Special-Topic-2565-01/Training_Base/Training_Based_Final.png

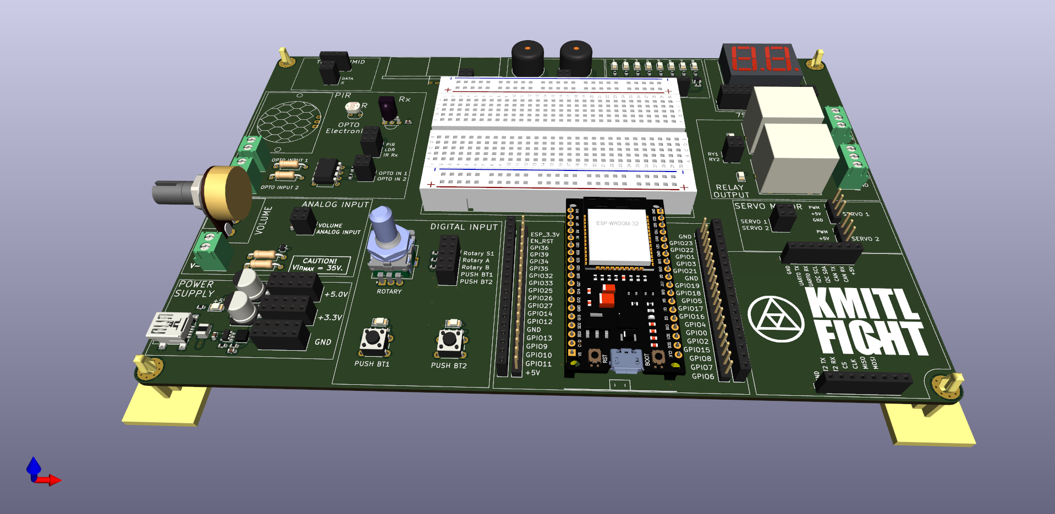
Training_Based_Final.png
