Special-Topic-2565-01/Training_Base/Training_Based.png

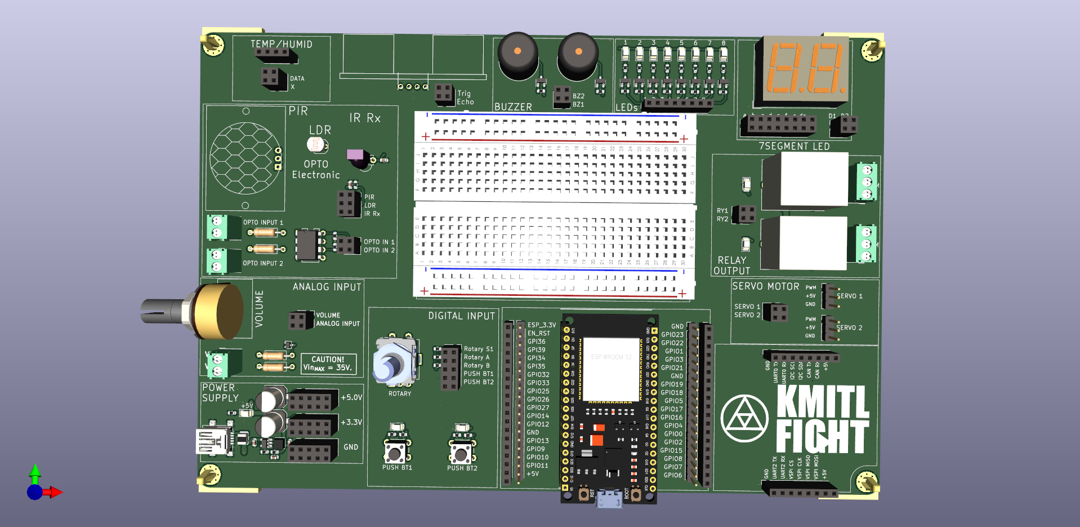
Training_Based.png
