Special-Topic-2565-01/Training_Base/README.md

# Training_Base
Training board base

## Components ##

### Temperature and Humidity sensor ###

## Design tool ##

### Kicad ### 
ใช้ Kicad รุ่นล่าสุด
ดาวน์โหลดจากที่นี่
https://www.kicad.org/download/
