Special-Topic-2565-01/Training_Base/3D Model/fuse_silicon_0603L.step

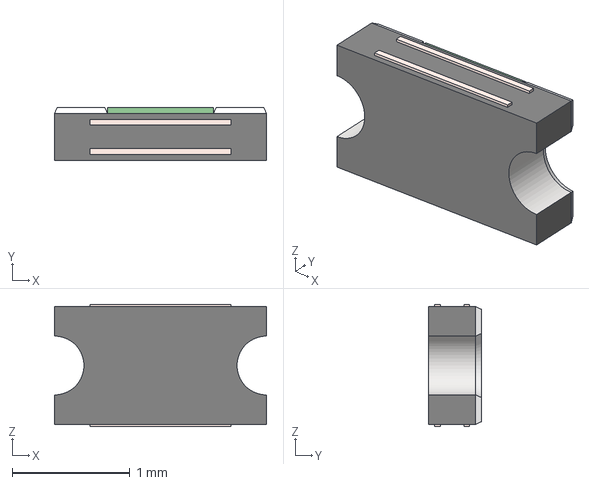
[picture p54: CAD file, 2022-07-24]
3D Model/fuse_silicon_0603L.step
1.80 x 0.45 x 1.04 mm
