Special-Topic-2565-01/Training_Base/3D Model/fuse_silicon_1206L.step

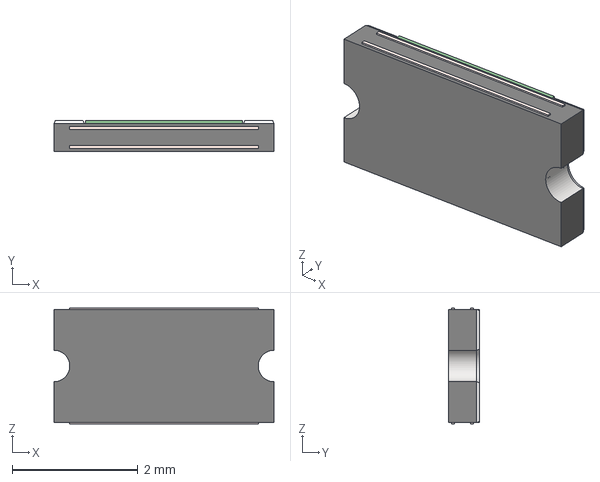
[picture p55: CAD file, 2022-07-24]
3D Model/fuse_silicon_1206L.step
3.50 x 0.5 x 1.84 mm
