Special-Topic-2565-01/Training_Base/3D Model/USB_Mini_B_SMD_buchse.STEP

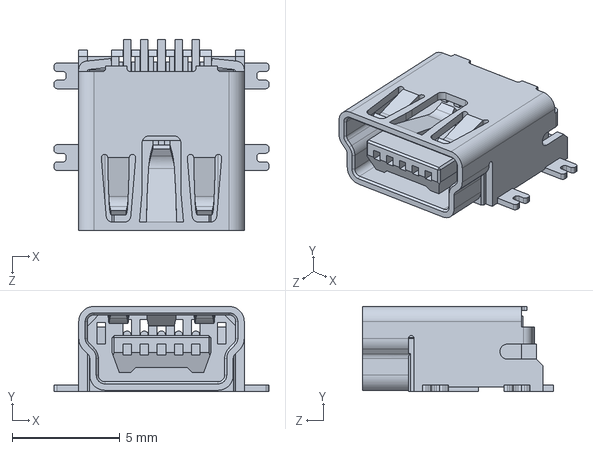
[picture p56: CAD file, 2022-07-24]
3D Model/USB_Mini_B_SMD_buchse.STEP
10.0 x 3.96 x 8.90 mm
