Special-Topic-2565-01/Training_Base/3D Model/fuse_silicon_0805L.step

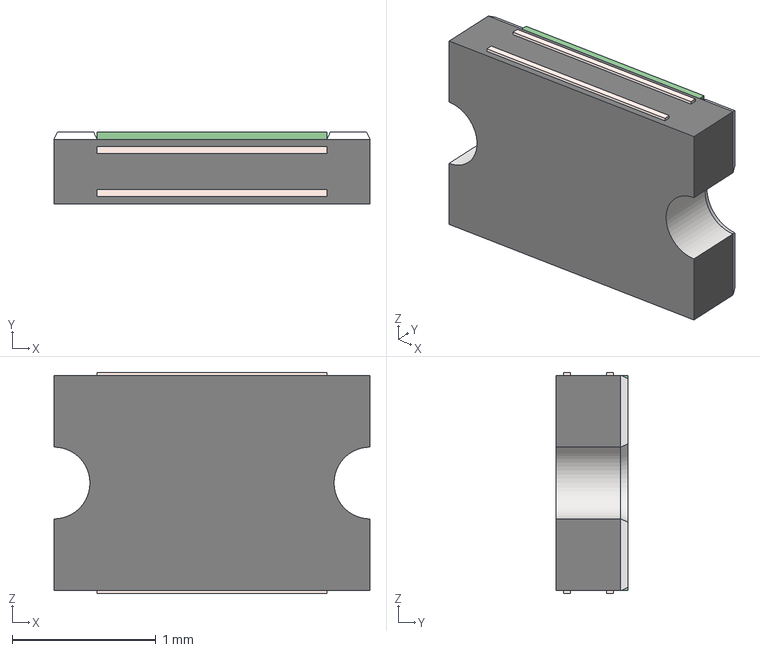
[picture p57: CAD file, 2022-07-24]
3D Model/fuse_silicon_0805L.step
2.20 x 0.5 x 1.54 mm
