Special-Topic-2565-01/Training_Base/3D Model/Potentiometer.step

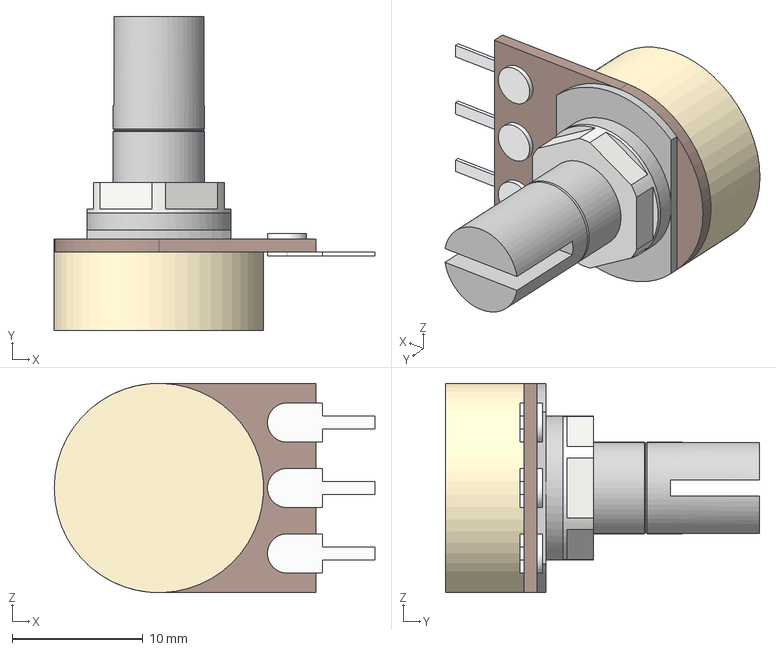
[picture p58: CAD file, 2022-07-24]
3D Model/Potentiometer.step
24.5 x 24.0 x 16.0 mm
Rotary top
Nut and washer
