Special-Topic-2565-01/Training_Base/3D Model/EC11B-SW-Vert-15F-green.step

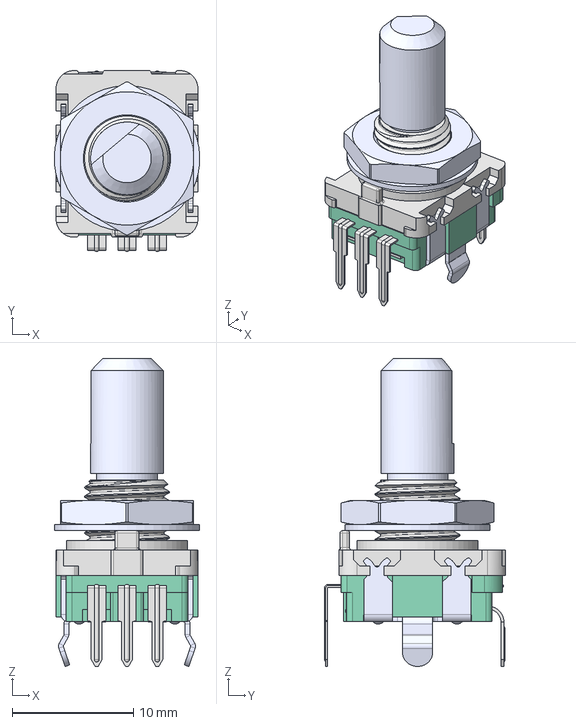
[picture p59: CAD file, 2022-07-24]
3D Model/EC11B-SW-Vert-15F-green.step
12.0 x 14.9 x 25.4 mm
