Special-Topic-2565-01/Training_Base/3D Model/DO-214AC.step

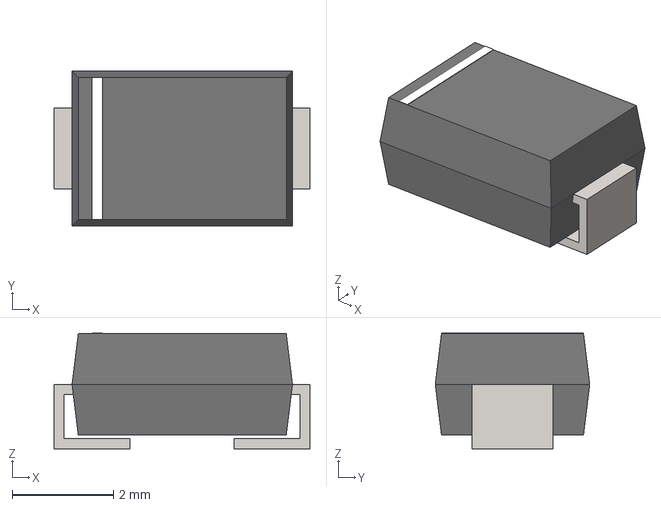
[picture p60: CAD file, 2022-07-23]
3D Model/DO-214AC.step
5.05 x 3.05 x 2.28 mm
