Special-Topic-2565-01/Training_Base/3D Model/DHT11.stp

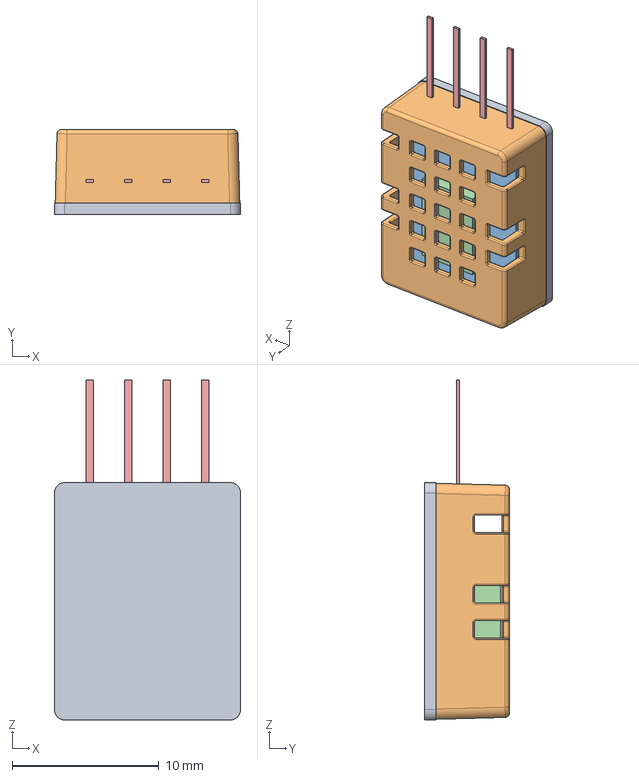
[picture p61: CAD file, 2022-07-23]
3D Model/DHT11.stp
12.7 x 5.80 x 23.2 mm
