Special-Topic-2565-01/Training_Base/3D Model/PIR_sensor board.STEP

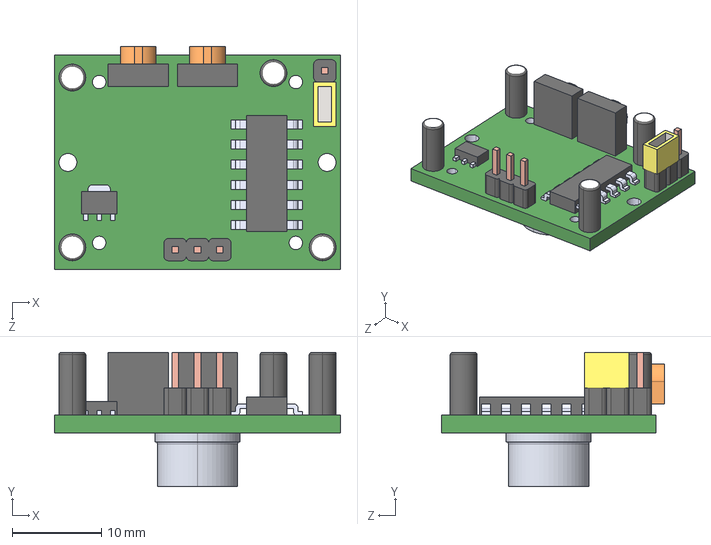
[picture p62: CAD file, 2022-07-22]
3D Model/PIR_sensor board.STEP
32.0 x 15.0 x 25.0 mm
