Special-Topic-2565-01/Training_Base/3D Model/PIR_lens.STEP

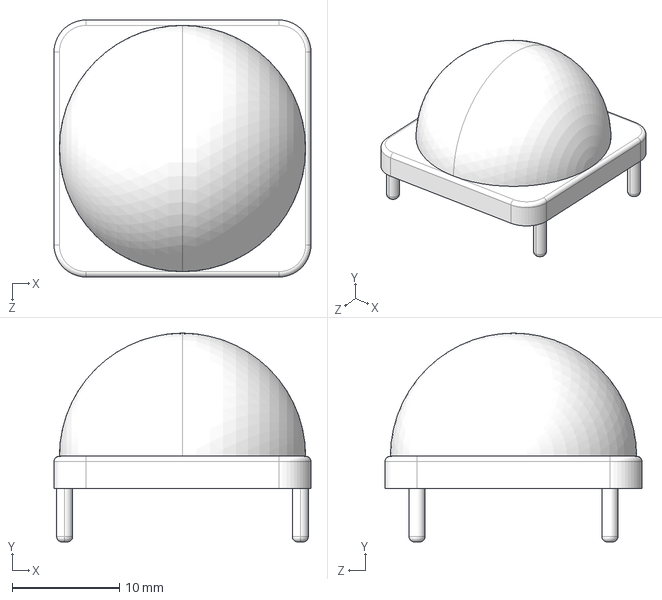
[picture p63: CAD file, 2022-07-22]
3D Model/PIR_lens.STEP
24.0 x 19.5 x 24.0 mm
