Special-Topic-2565-01/Training_Base/3D Model/Plastic Stick Fixed Clip On PCB.stp

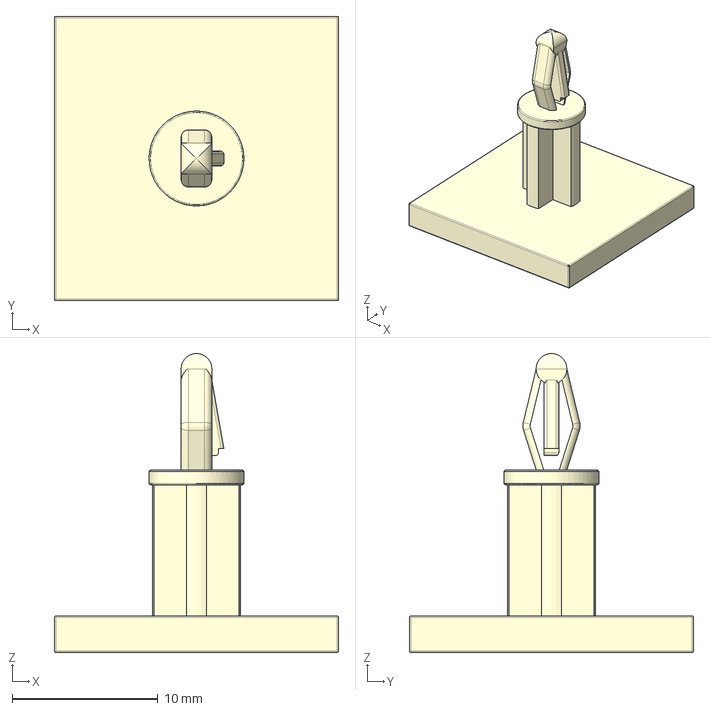
[picture p64: CAD file, 2022-07-21]
3D Model/Plastic Stick Fixed Clip On PCB.stp
19.5 x 19.5 x 20.5 mm
