Special-Topic-2565-01/Training_Base/3D Model/KPM-1205A.STEP

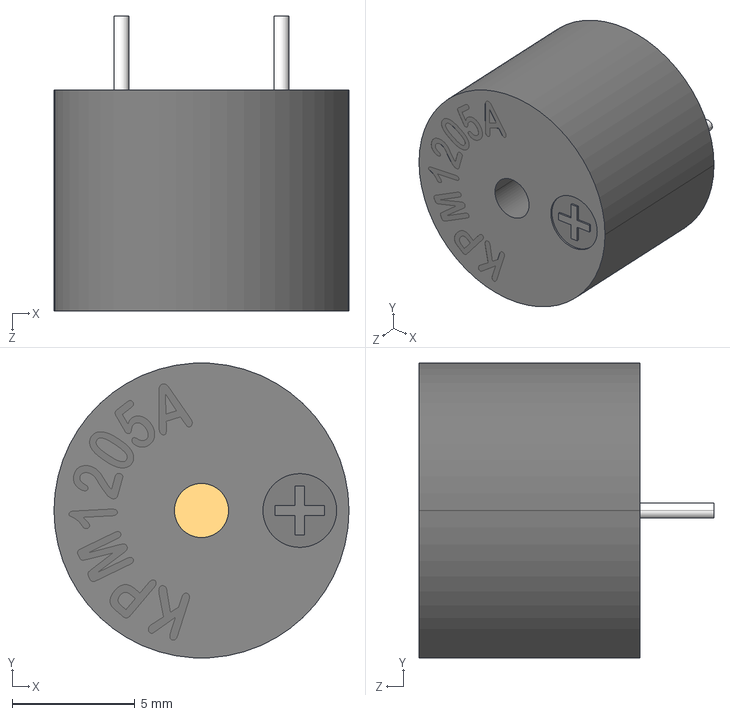
[picture p65: CAD file, 2022-07-21]
3D Model/KPM-1205A.STEP
12.0 x 12.0 x 12.0 mm
