Special-Topic-2565-01/Training_Base/3D Model/Buzzer.step

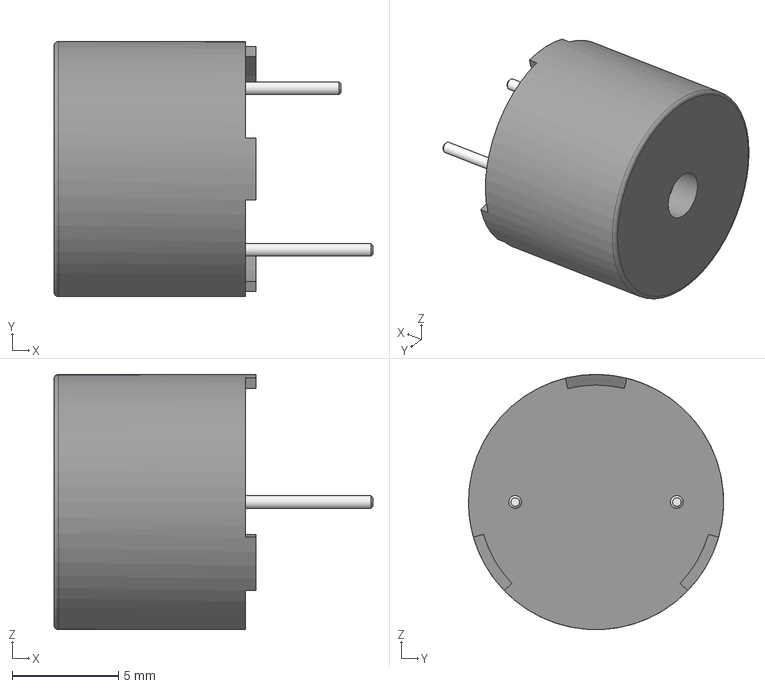
[picture p66: CAD file, 2022-07-21]
3D Model/Buzzer.step
15.0 x 12.0 x 12.0 mm
