Special-Topic-2565-01/Training_Base/3D Model/esp32_devkit_v1_doit.step

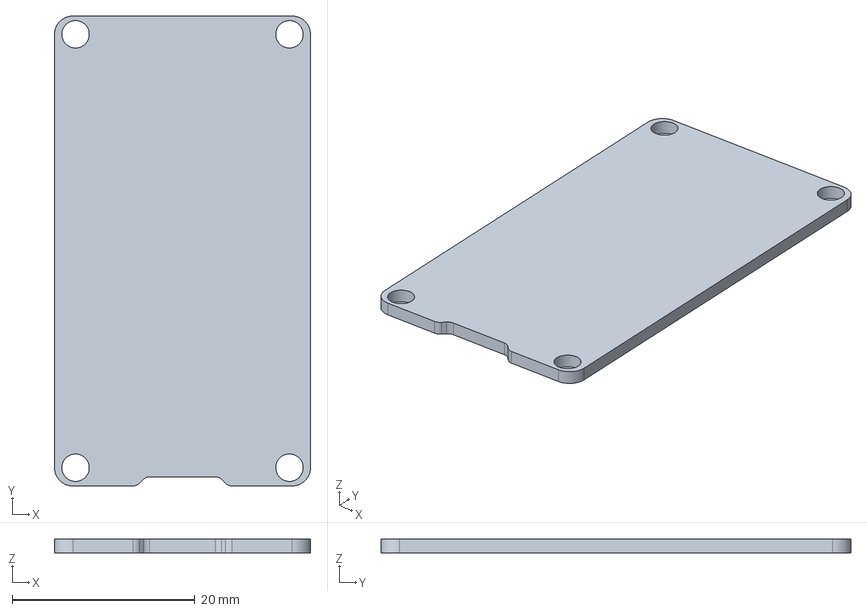
[picture p67: CAD file, 2022-07-21]
3D Model/esp32_devkit_v1_doit.step
28.0 x 51.4 x 1.50 mm
