Special-Topic-2565-01/Training_Base/(list of files, cad)

Other CAD files:
3D Model/PIR_sensor.STEP
