Special-Topic-2565-01/Training_Base/Training_Based.pdf

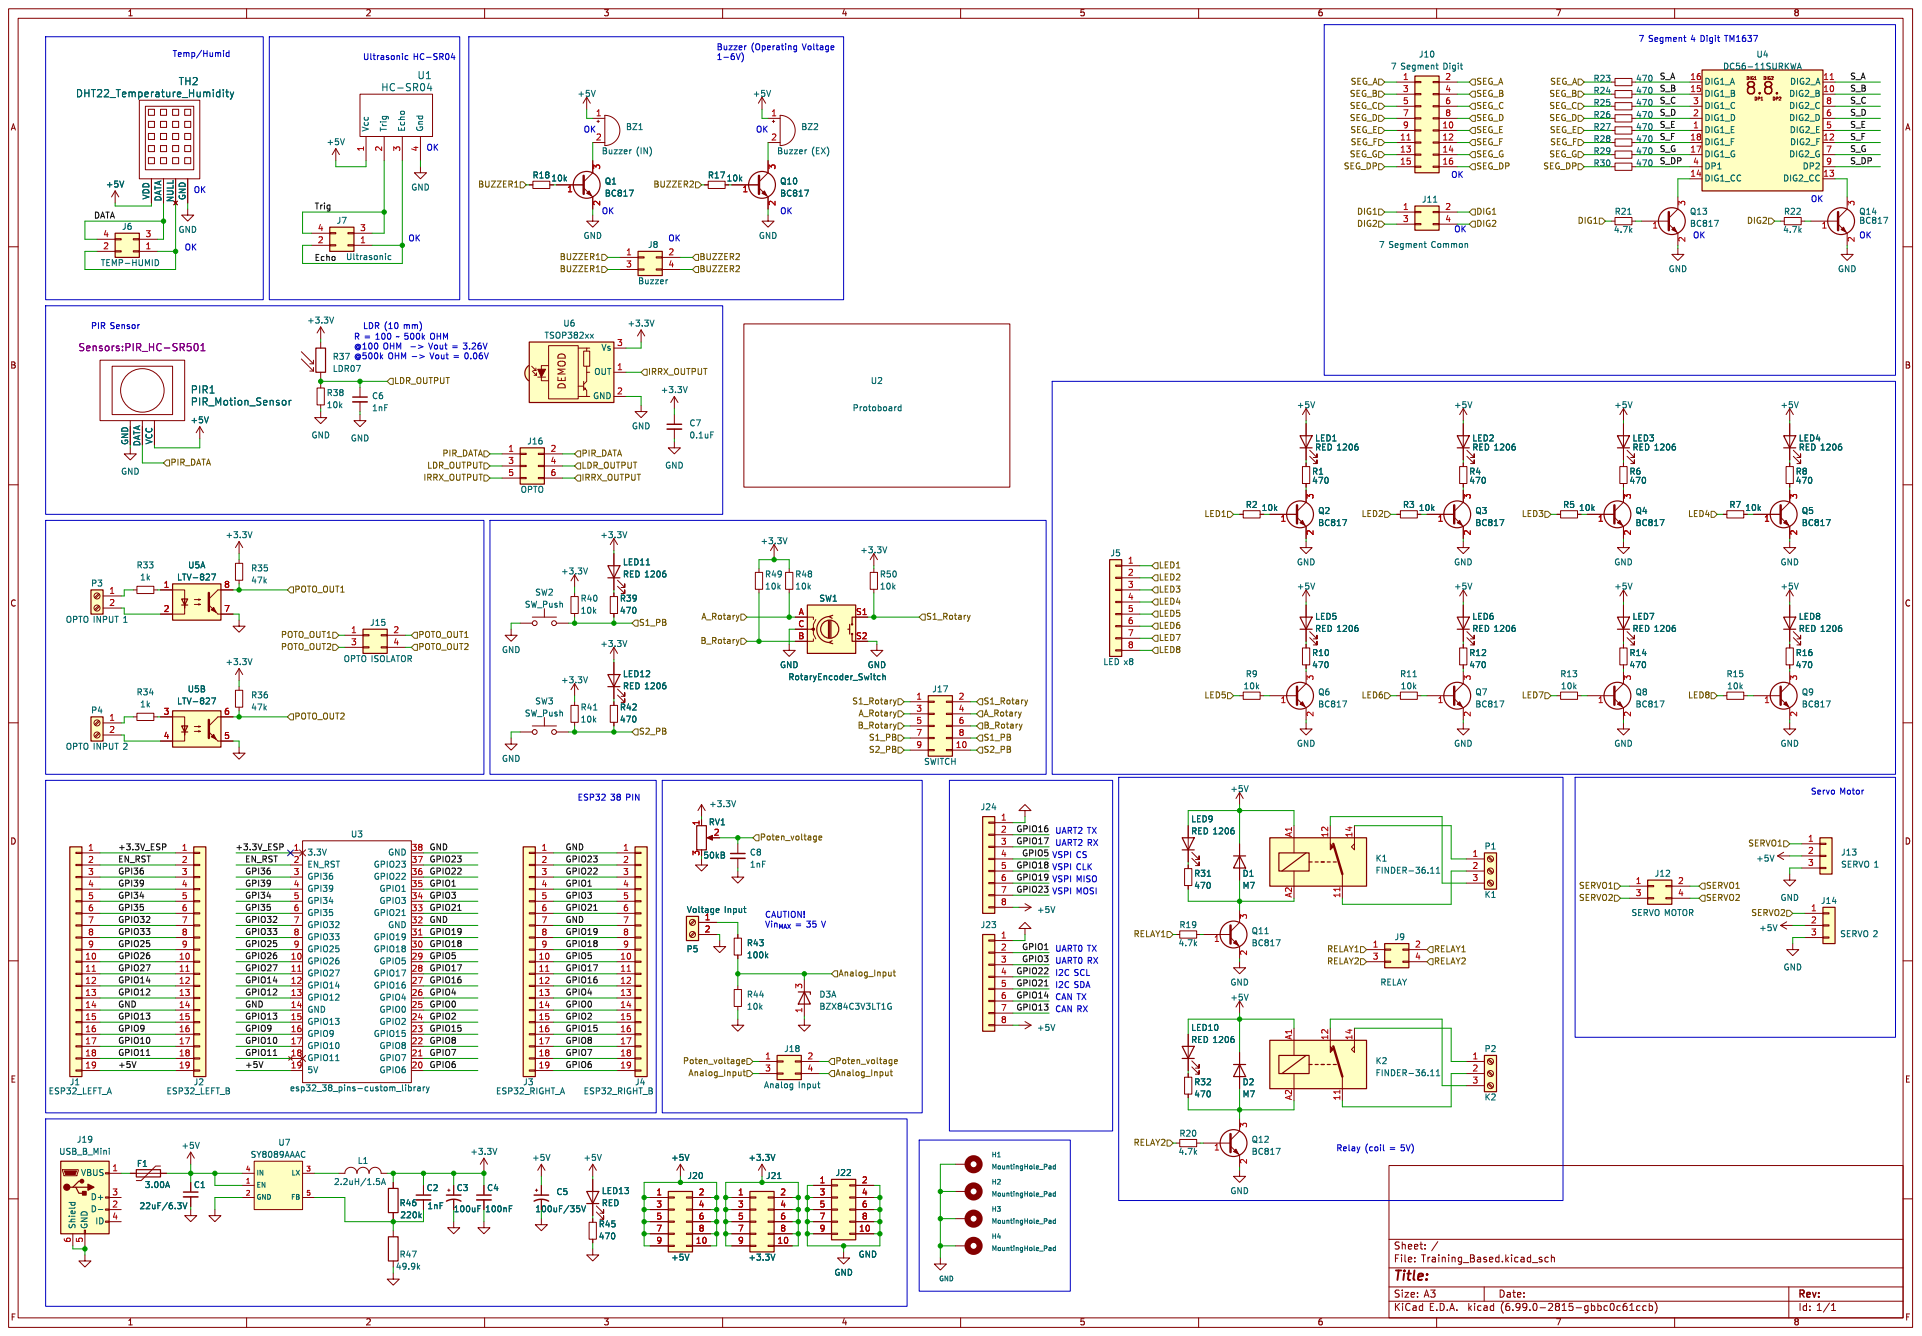
[picture p68: page 1]

LDR (10 mm)
R = 100 ~ 500k OHM @100 OHM -> Vout = 3.26V @500k OHM -> Vout = 0.06V
IRRX_OUTPUTS2_PB

Sensors:PIR_HC-SR501 GND DATA VCC

VSPI CLK CAUTION! Vin_{MAX} = 35 V
