Special-Topic-2565-01/Training_Base/Schematic_650818.pdf

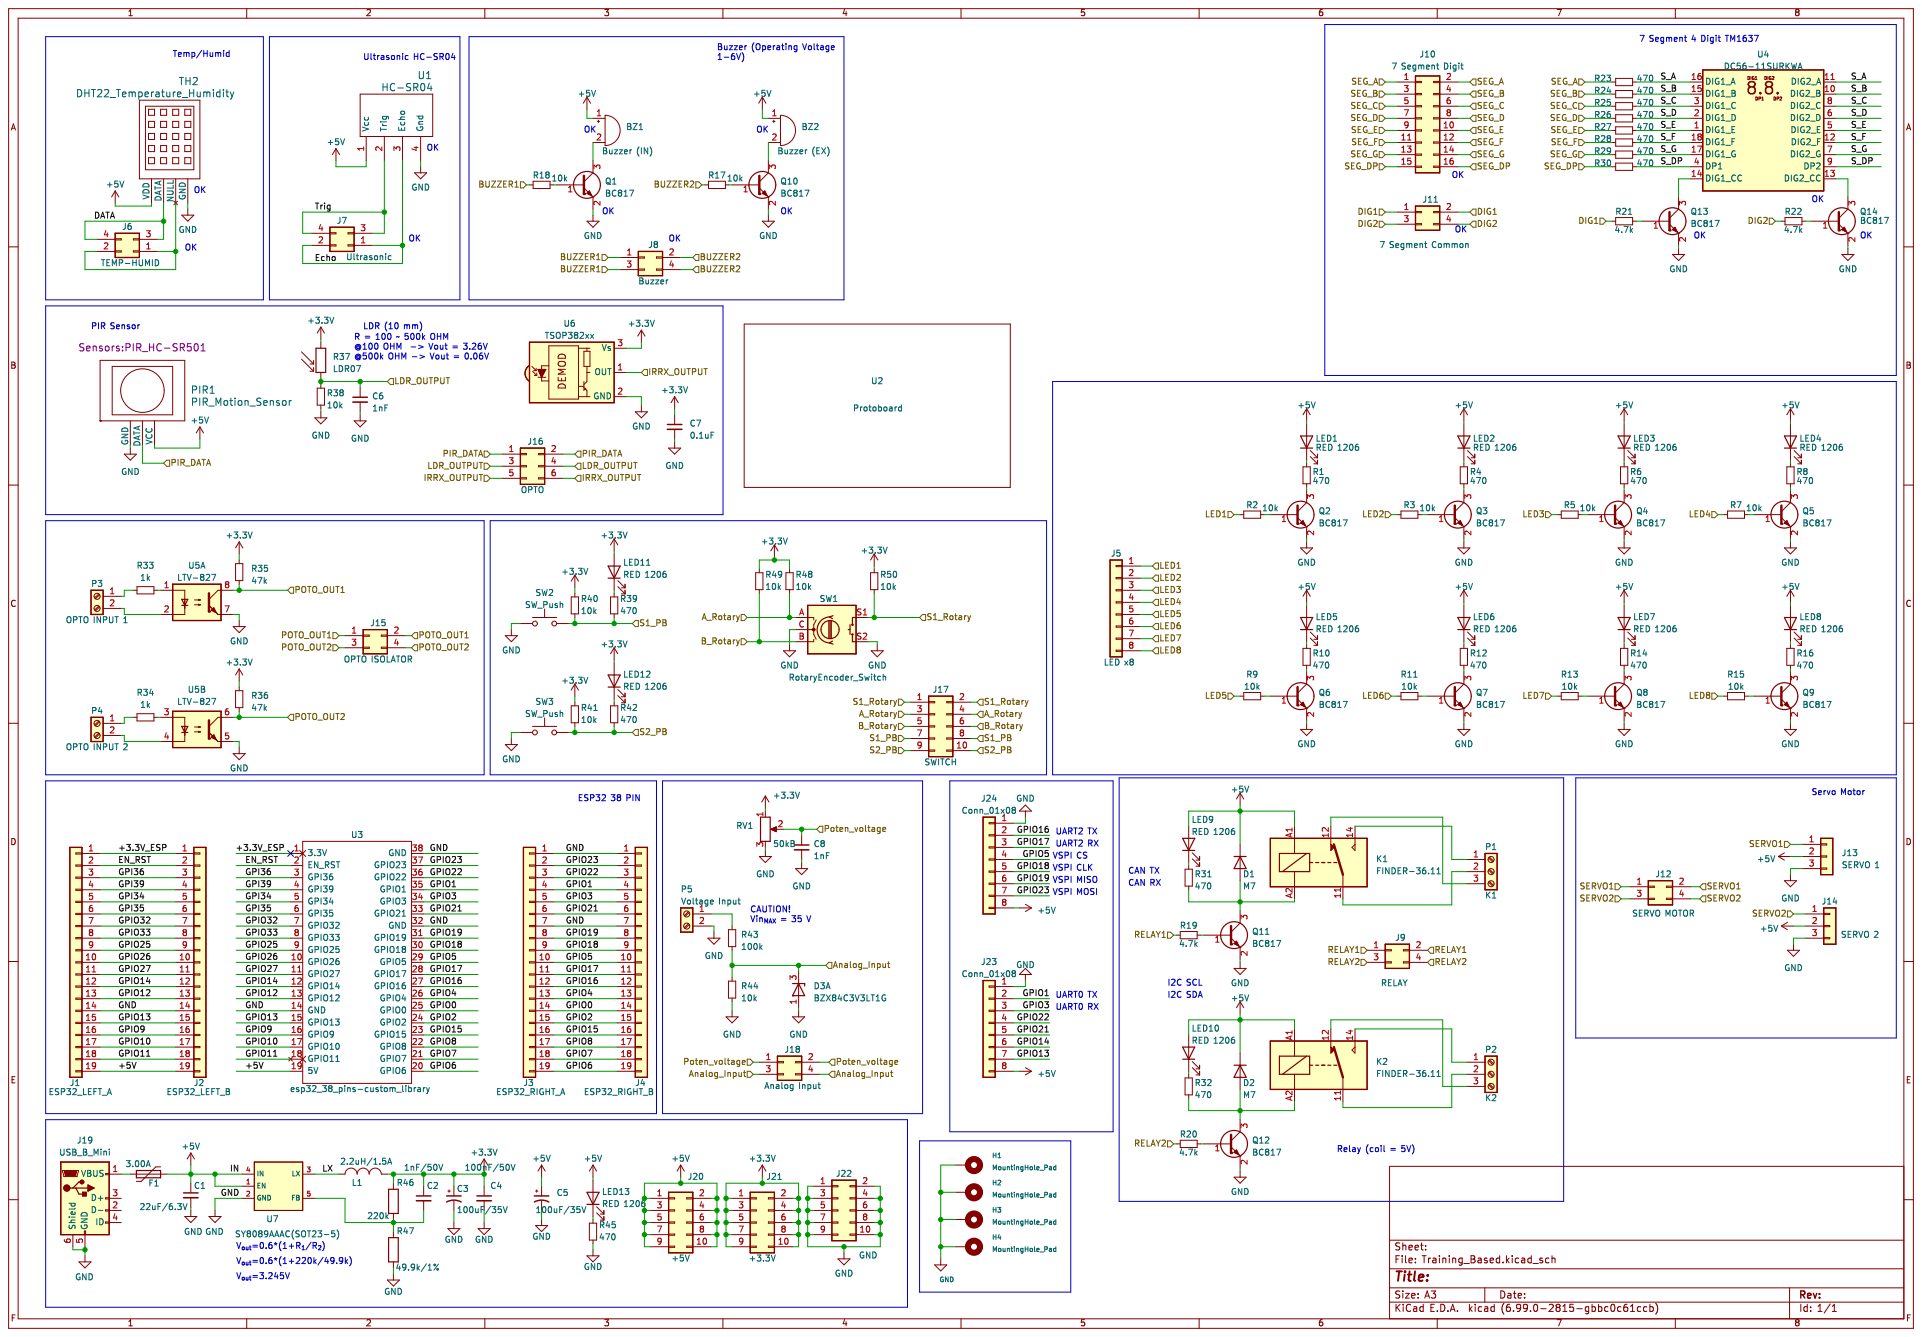
[picture p69: page 1]
