Special-Topic-2565-01/Training_Base/Schematic_650807.pdf

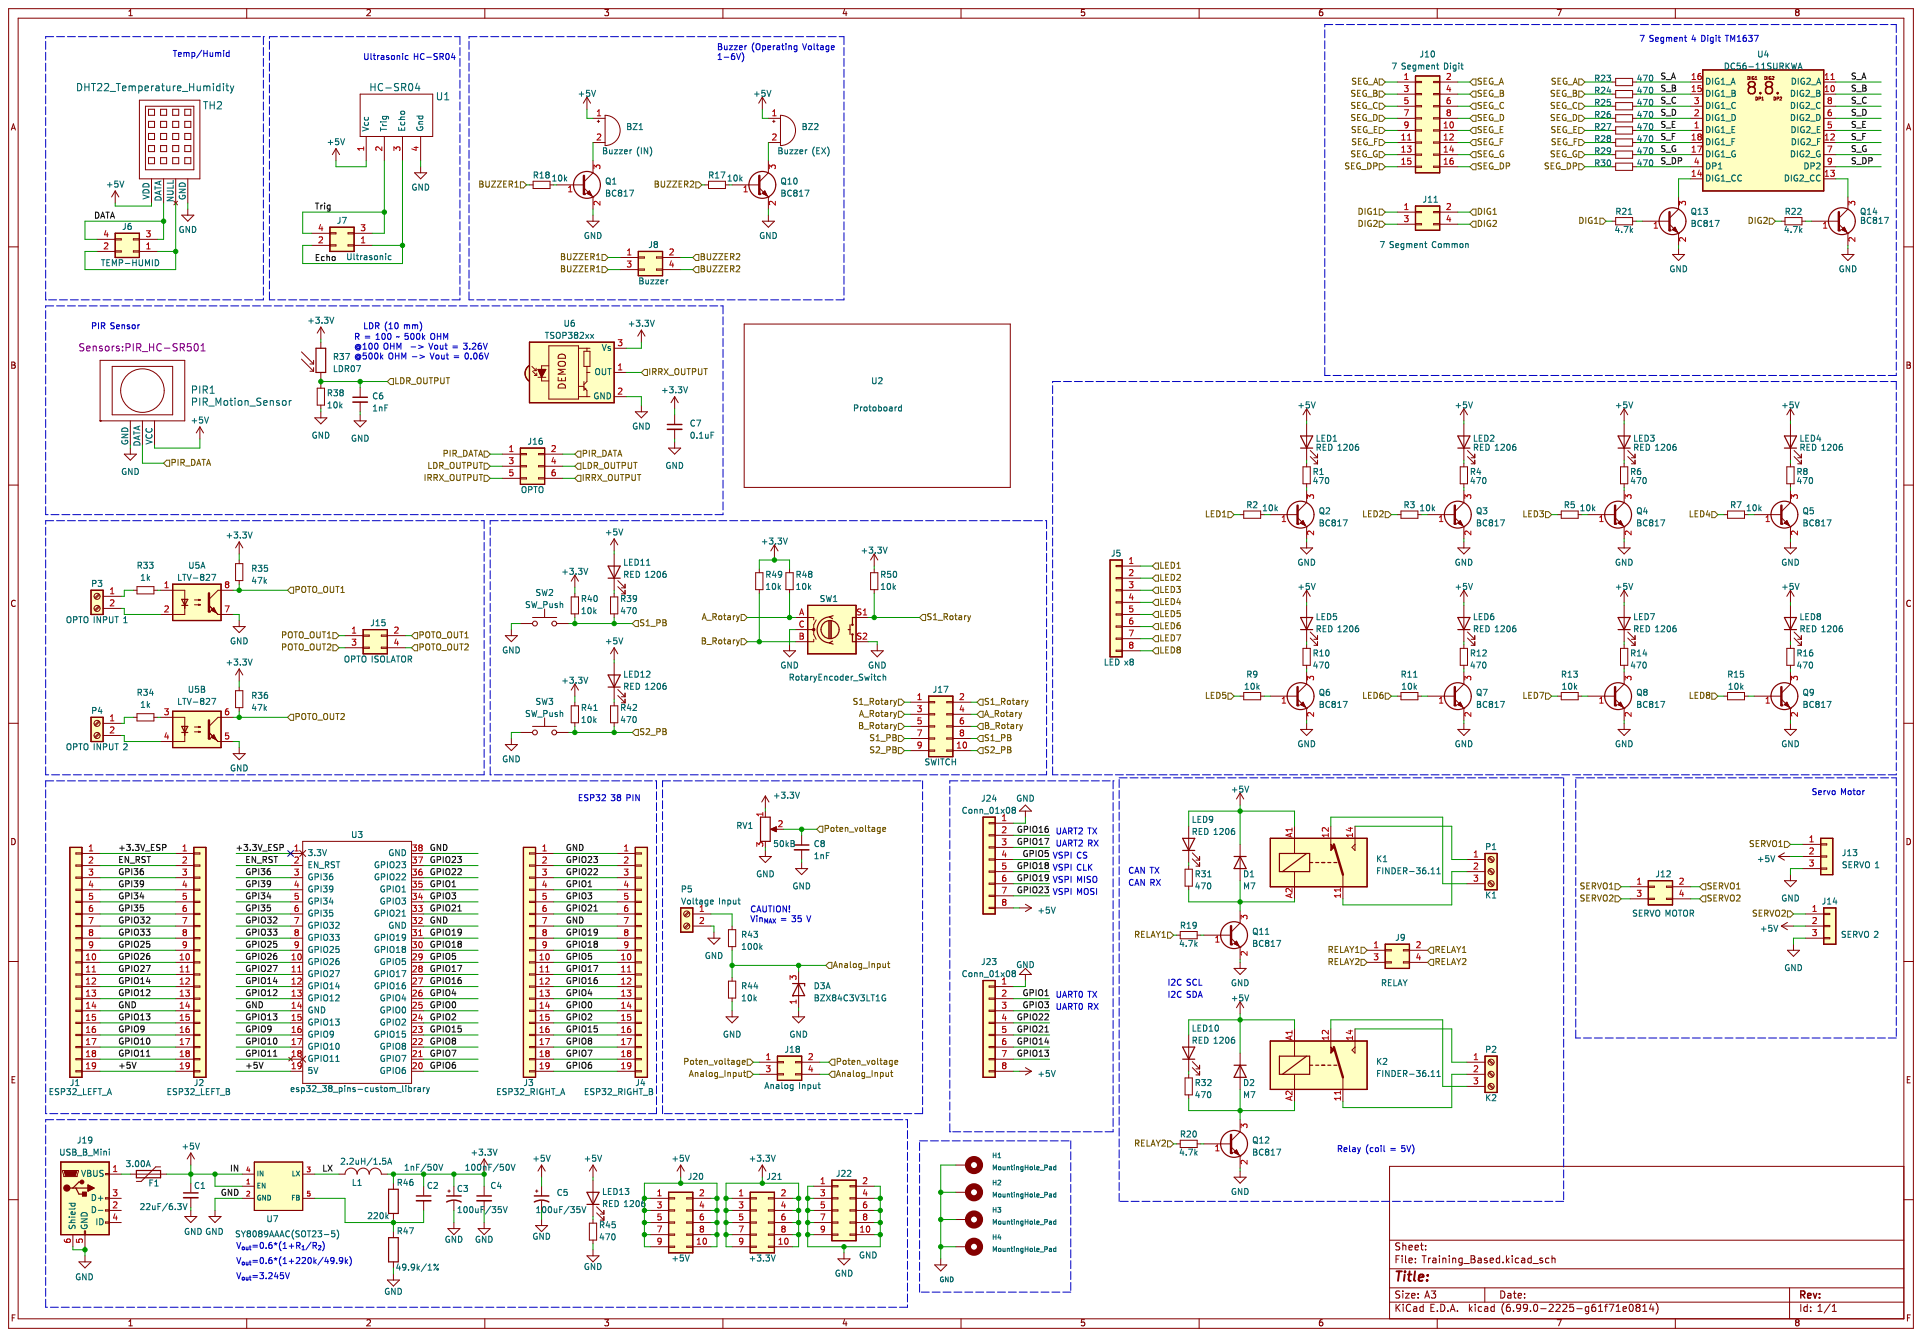
[picture p70: page 1]
