Special-Topic-2565-01/Training_Base/Schematic_650806.pdf

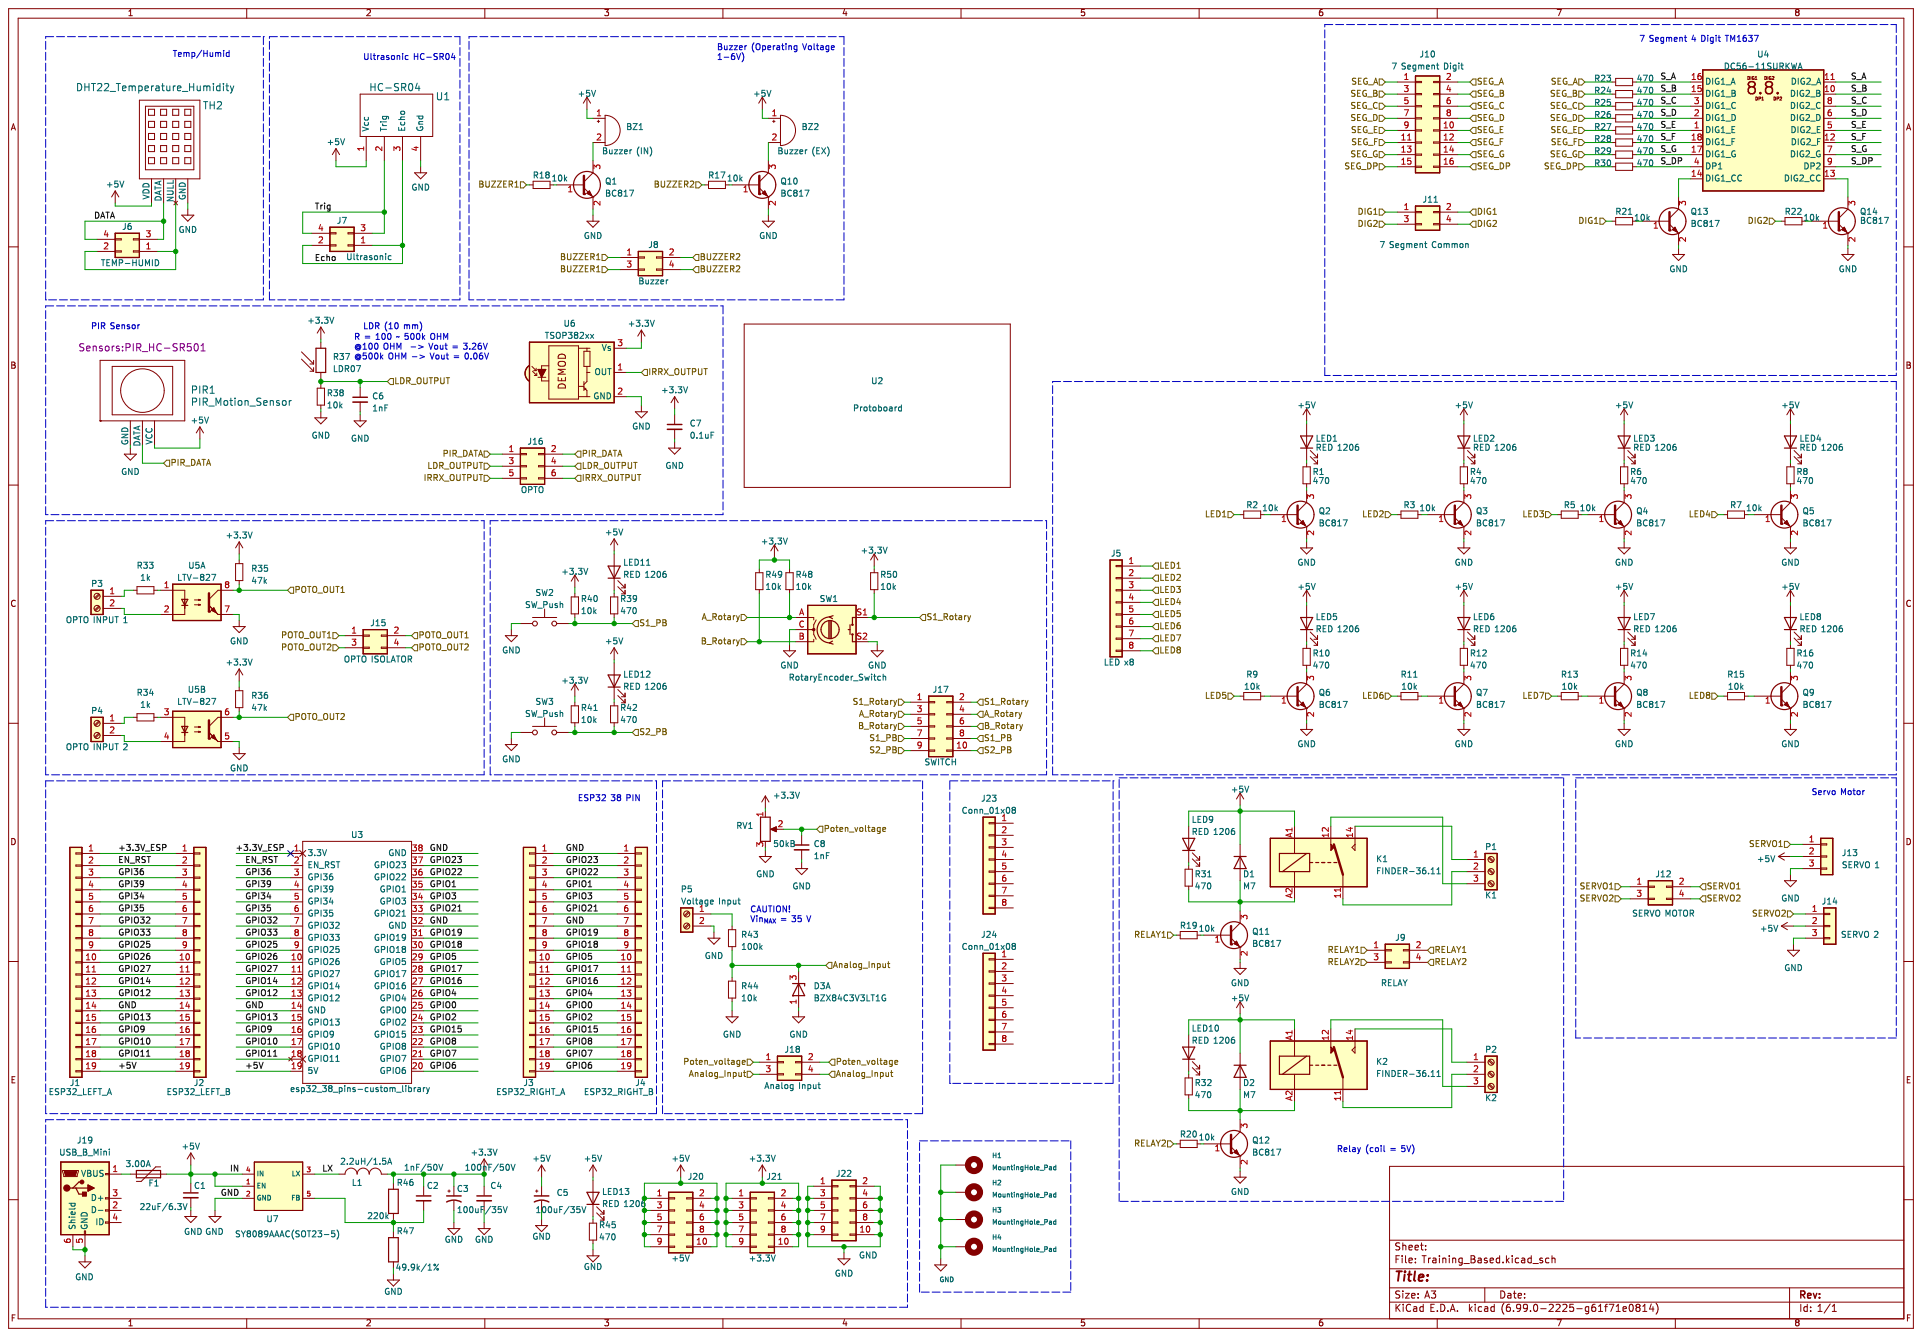
[picture p71: page 1]
