Special-Topic-2565-01/Training_Base/Layout/schematic.pdf

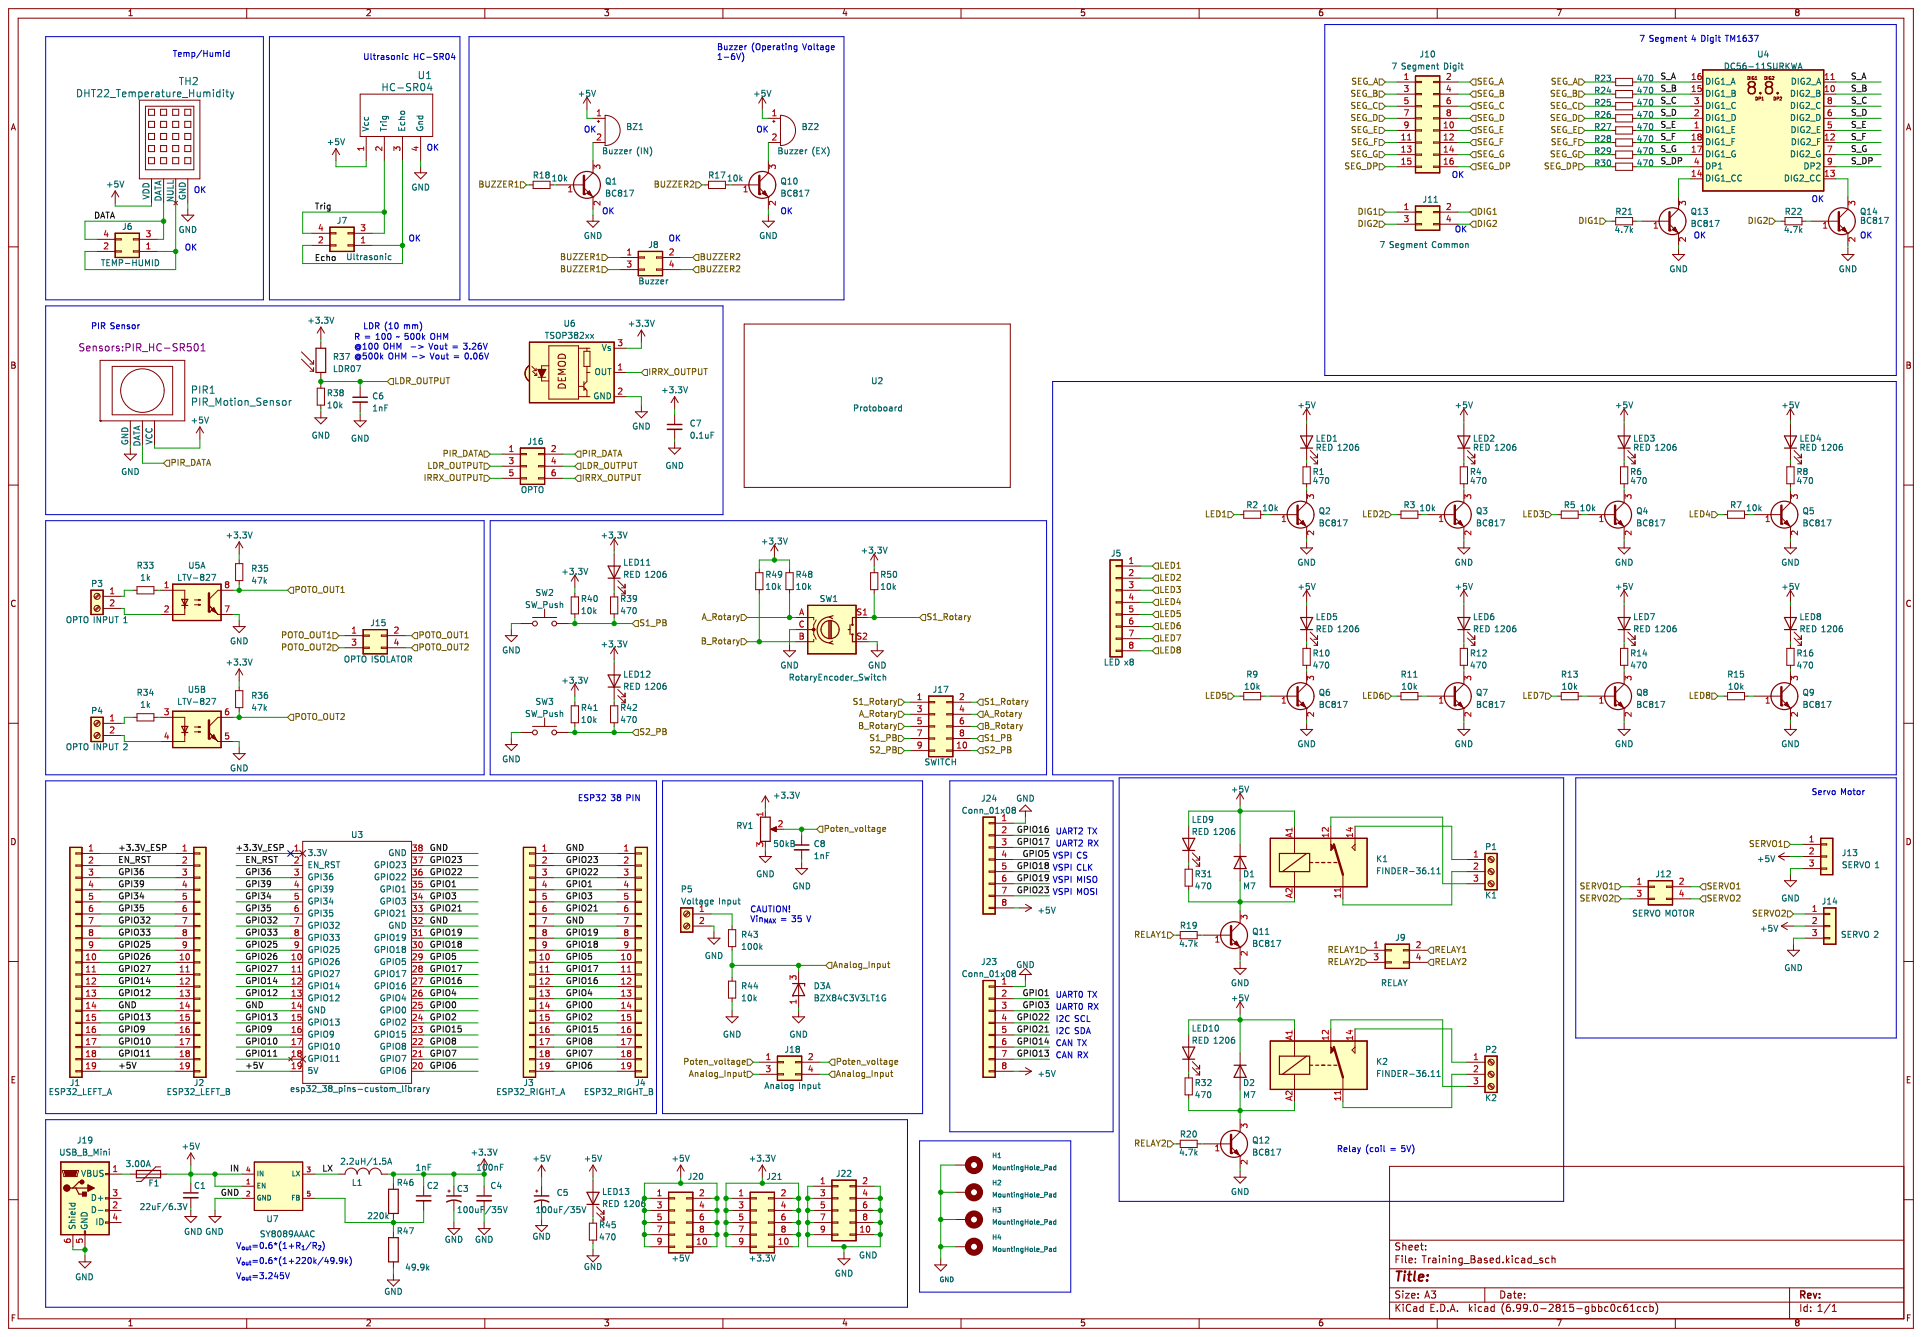
[picture p72: page 1]
