Special-Topic-2565-01/Training_Base/Layout_650807.pdf

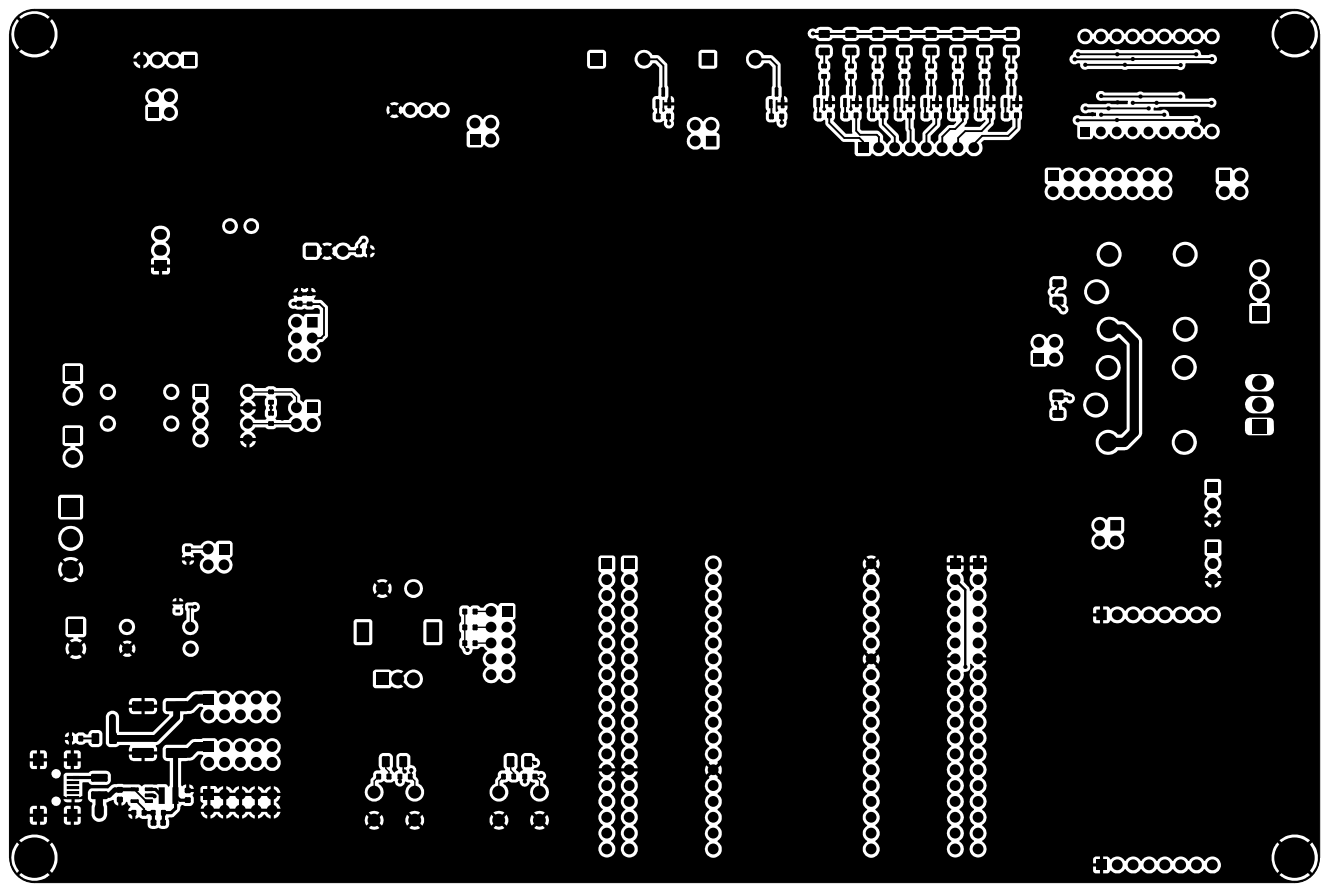
[picture p73: page 1]

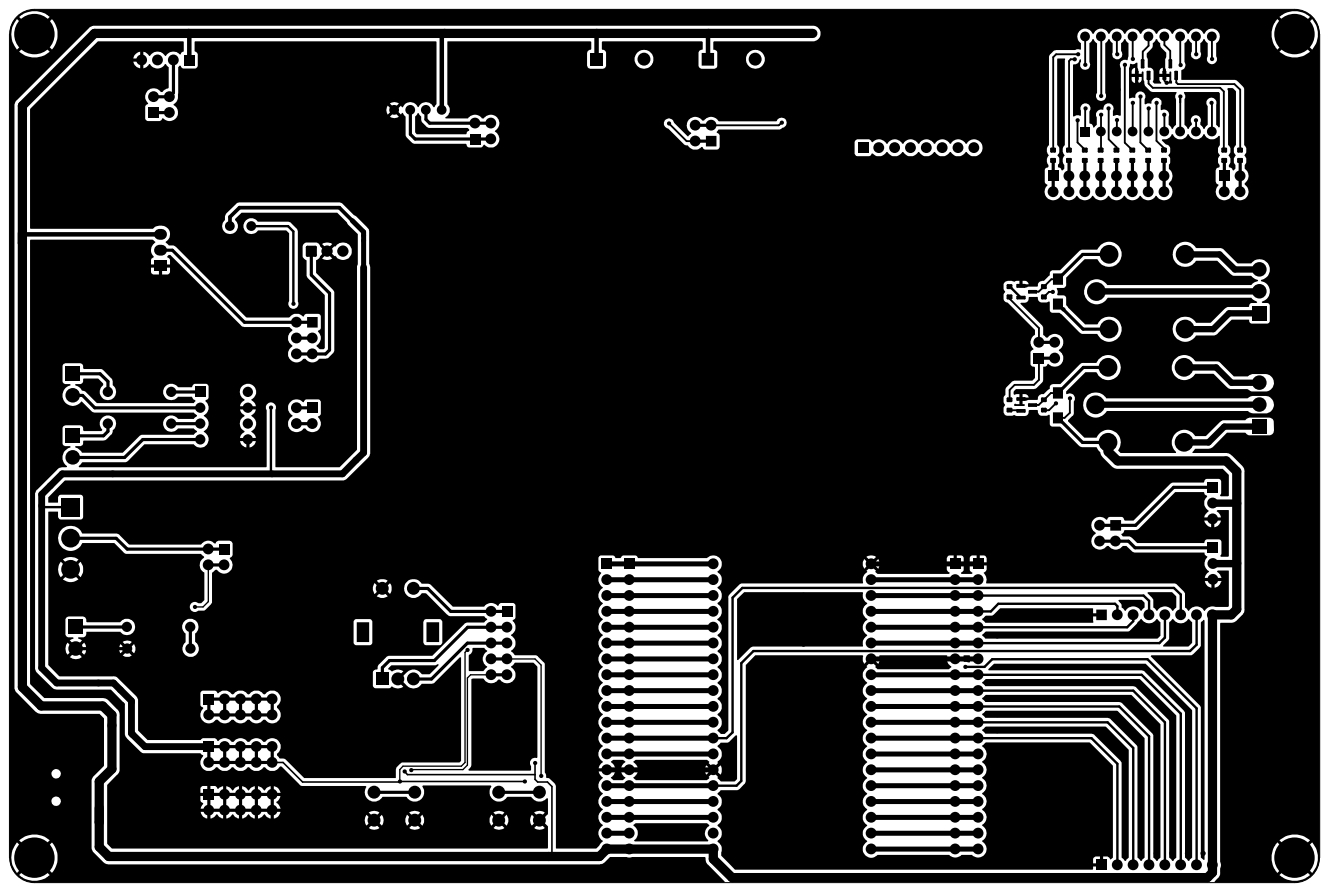
[picture p74: page 2]

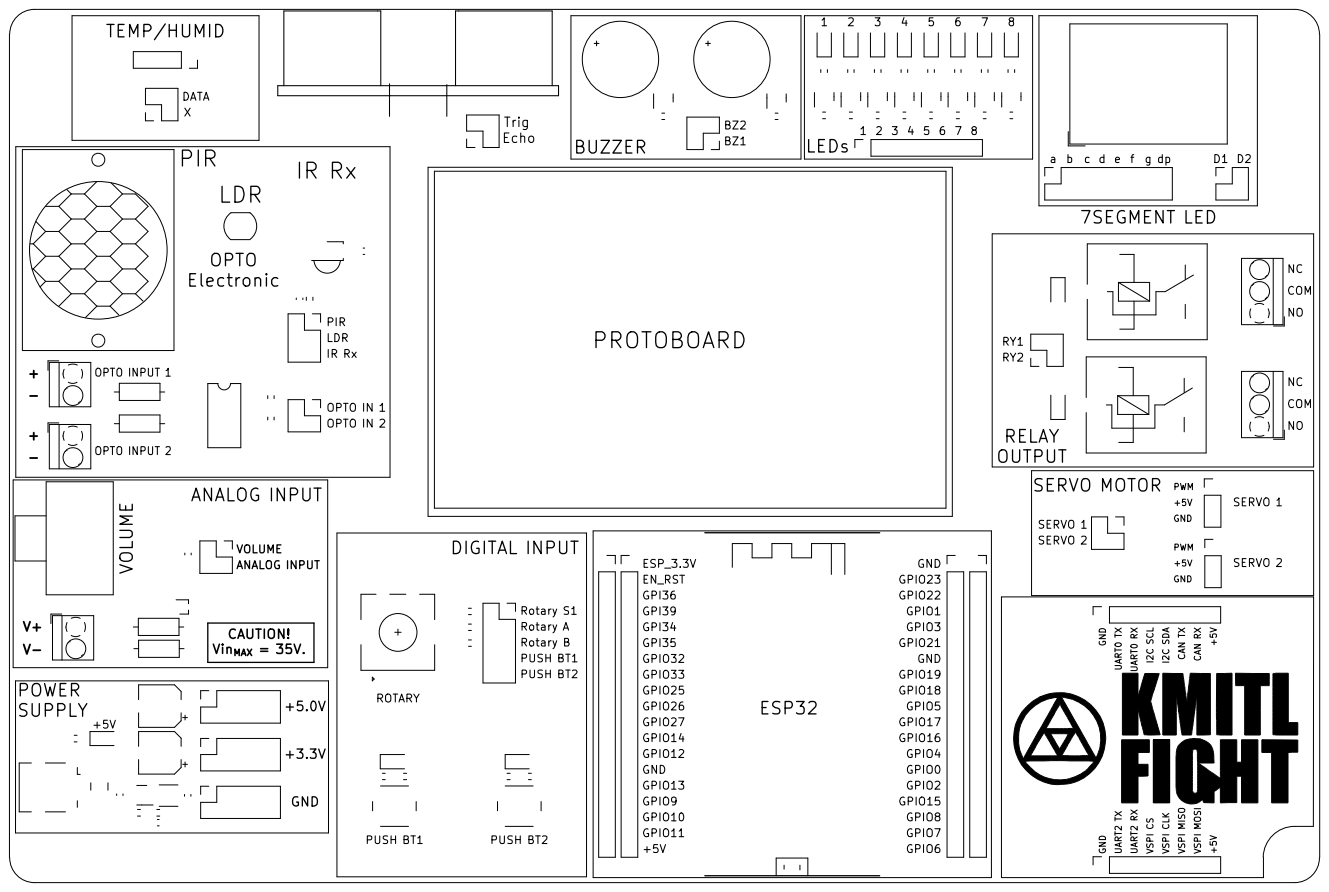
[picture p75: page 3]

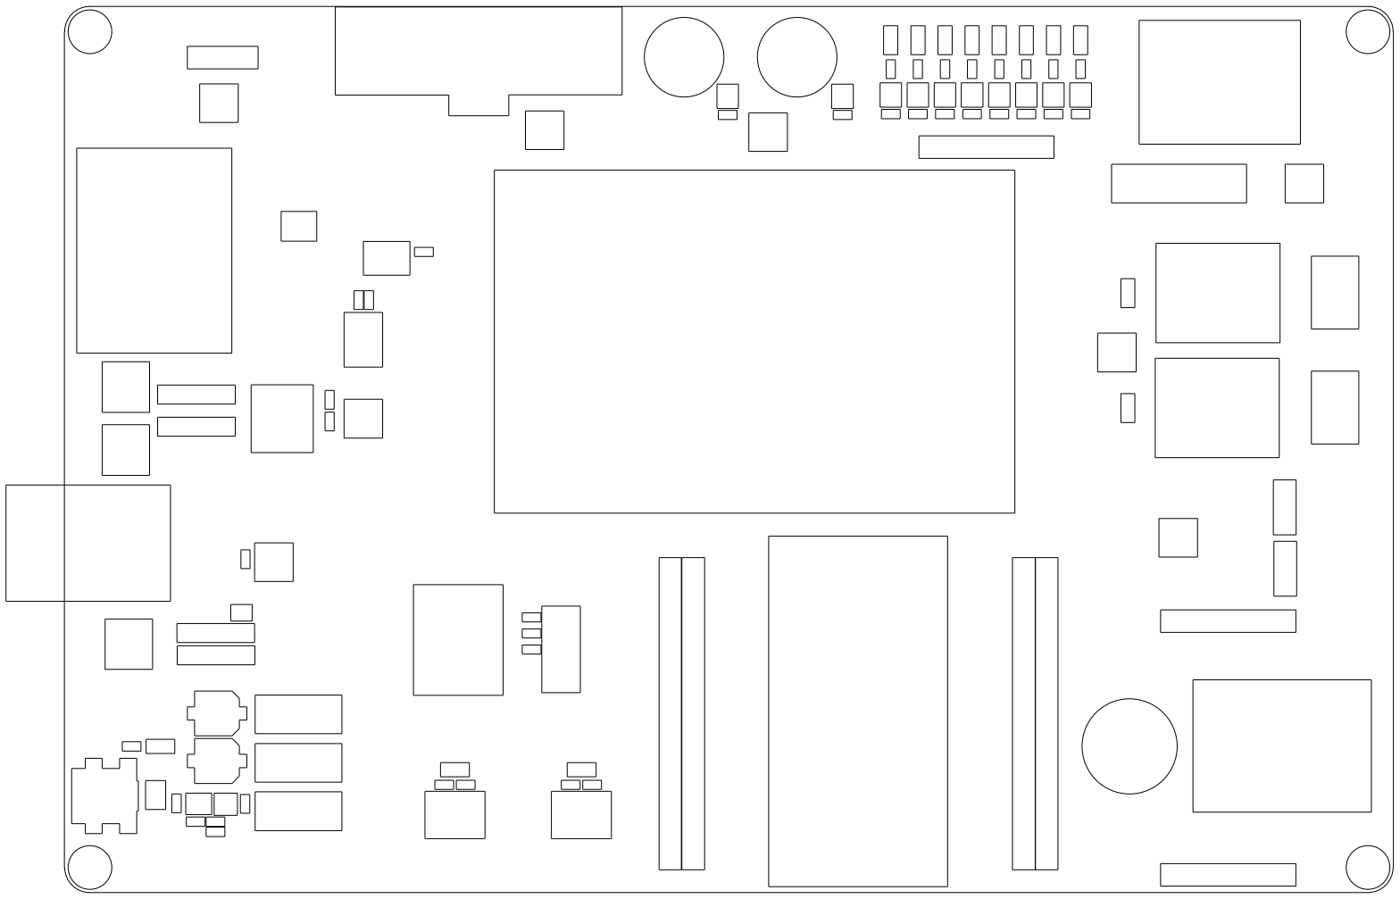
[picture p76: figure]
