Special-Topic-2565-01/Training_Base/layout_rev1.pdf

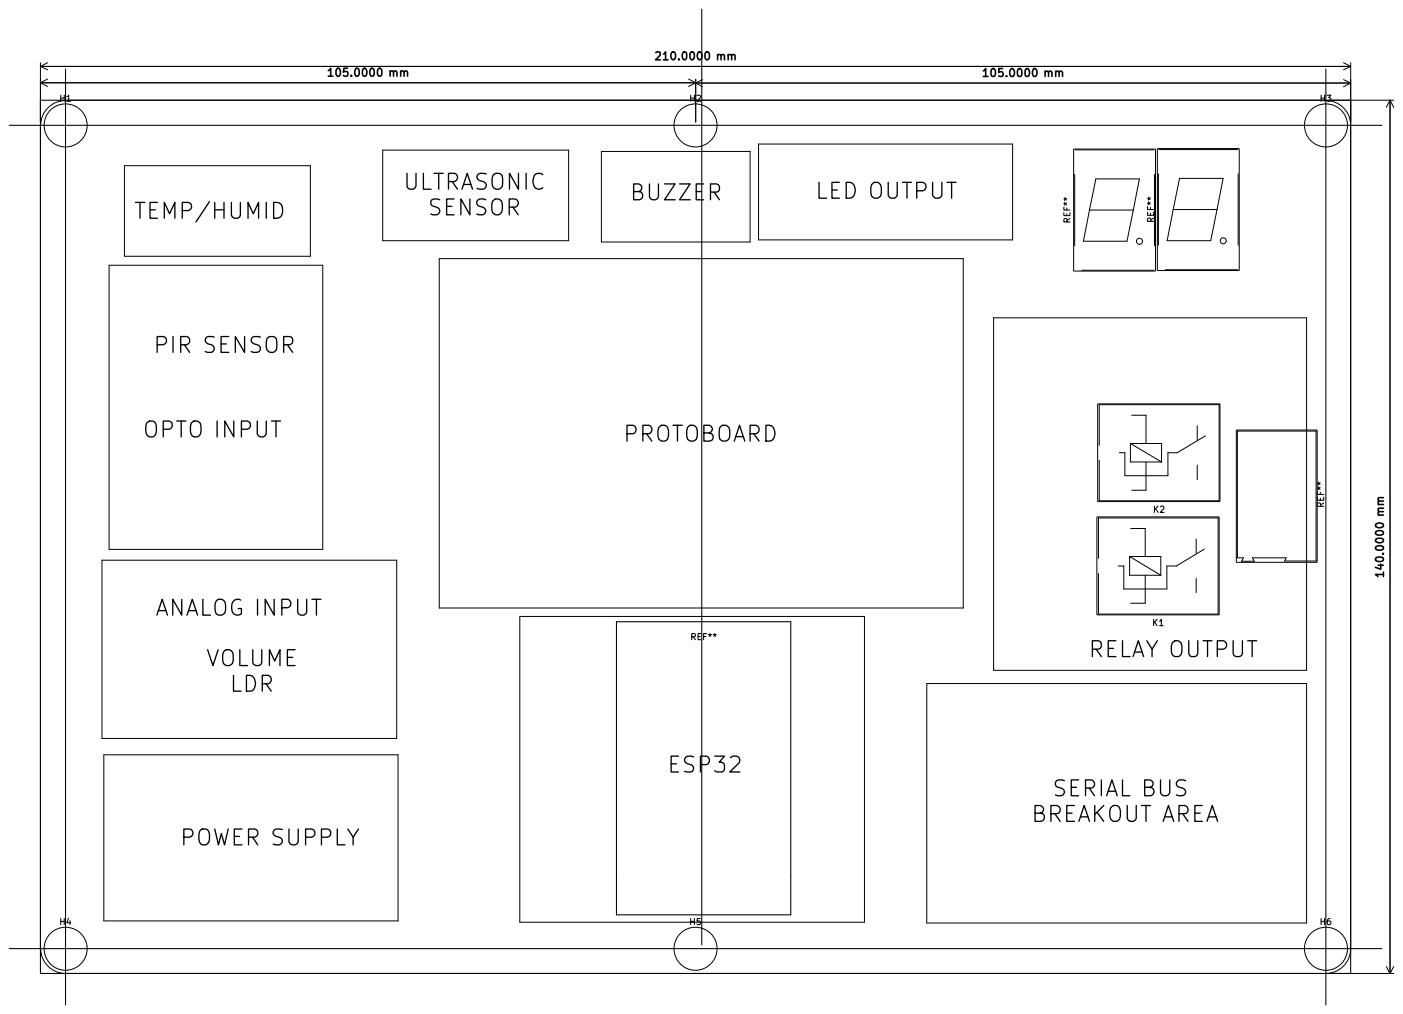
[picture p77: page 1]
