Special-Topic-2565-01/Training_Base/Gerber/Training_Based-B_Cu.pdf

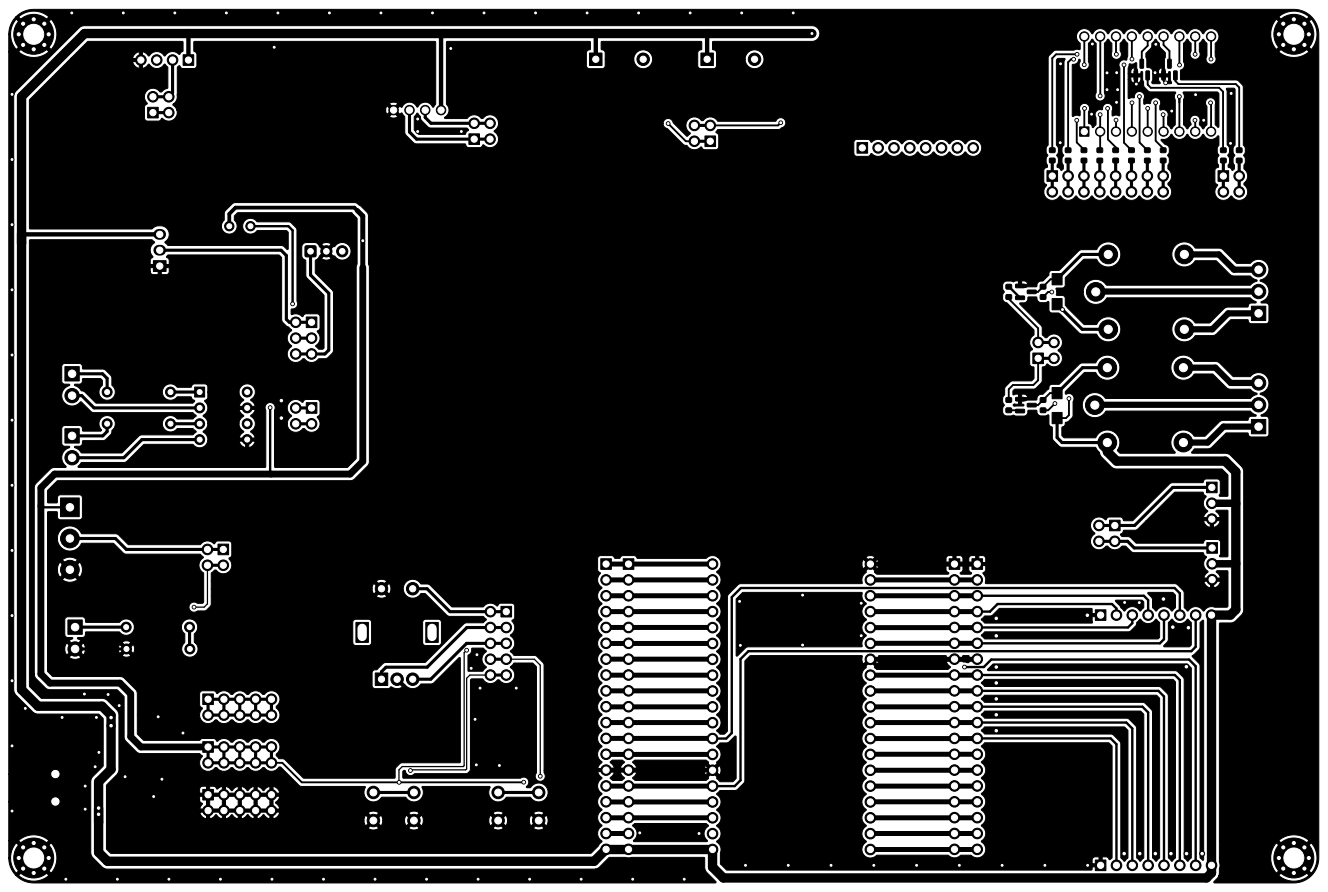
[picture p78: page 1]
