Special-Topic-2565-01/Training_Base/Gerber/Training_Based-F_Cu.pdf

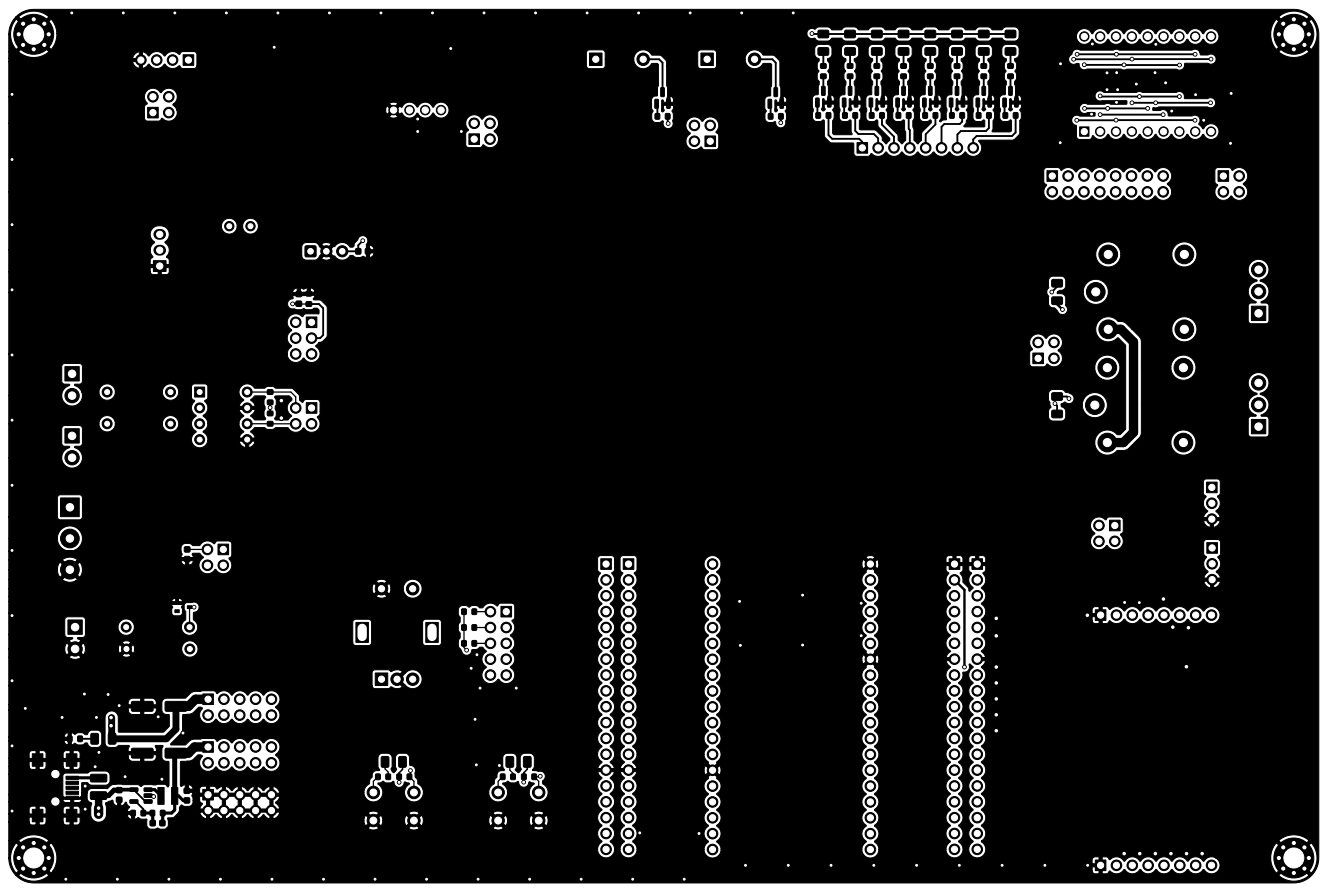
[picture p79: page 1]
