Special-Topic-2565-01/Training_Base/Gerber/Training_Based-F_Silkscreen.pdf

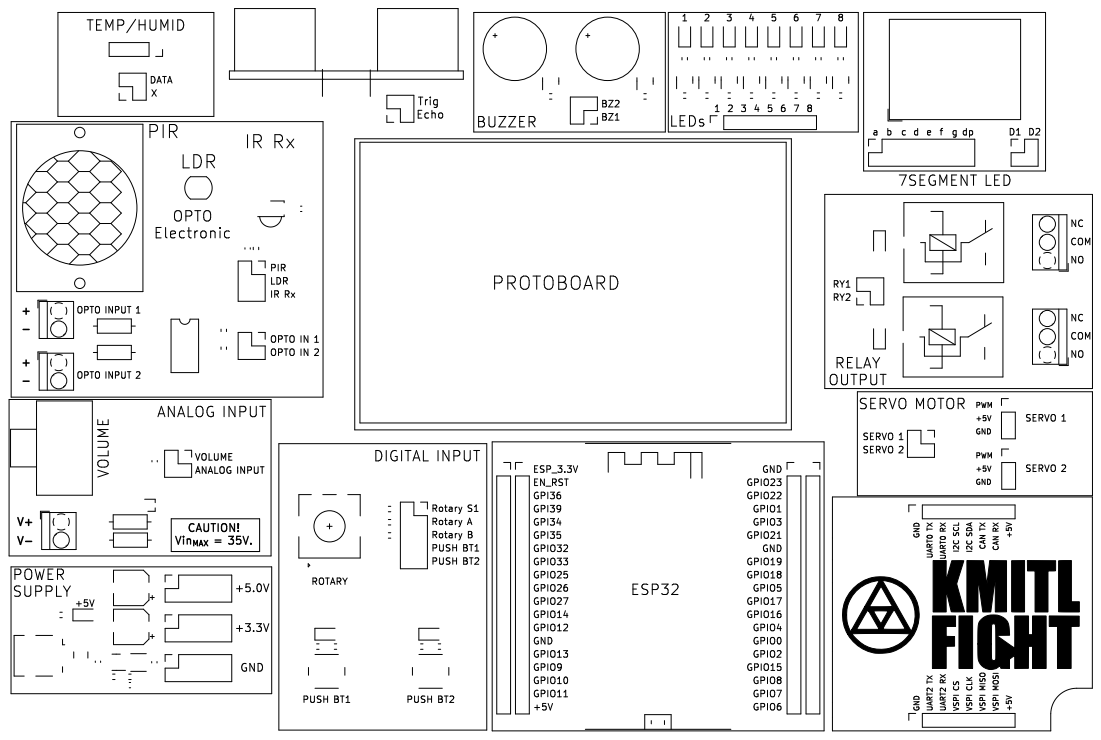
[picture p80: page 1]

4 OPTO IN 2 OPTO IN 1
