Special-Topic-2565-01/Training_Base/Training_Based.kicad_pcb

## KiCad design Training_Based.kicad_pcb (2023-06-14)

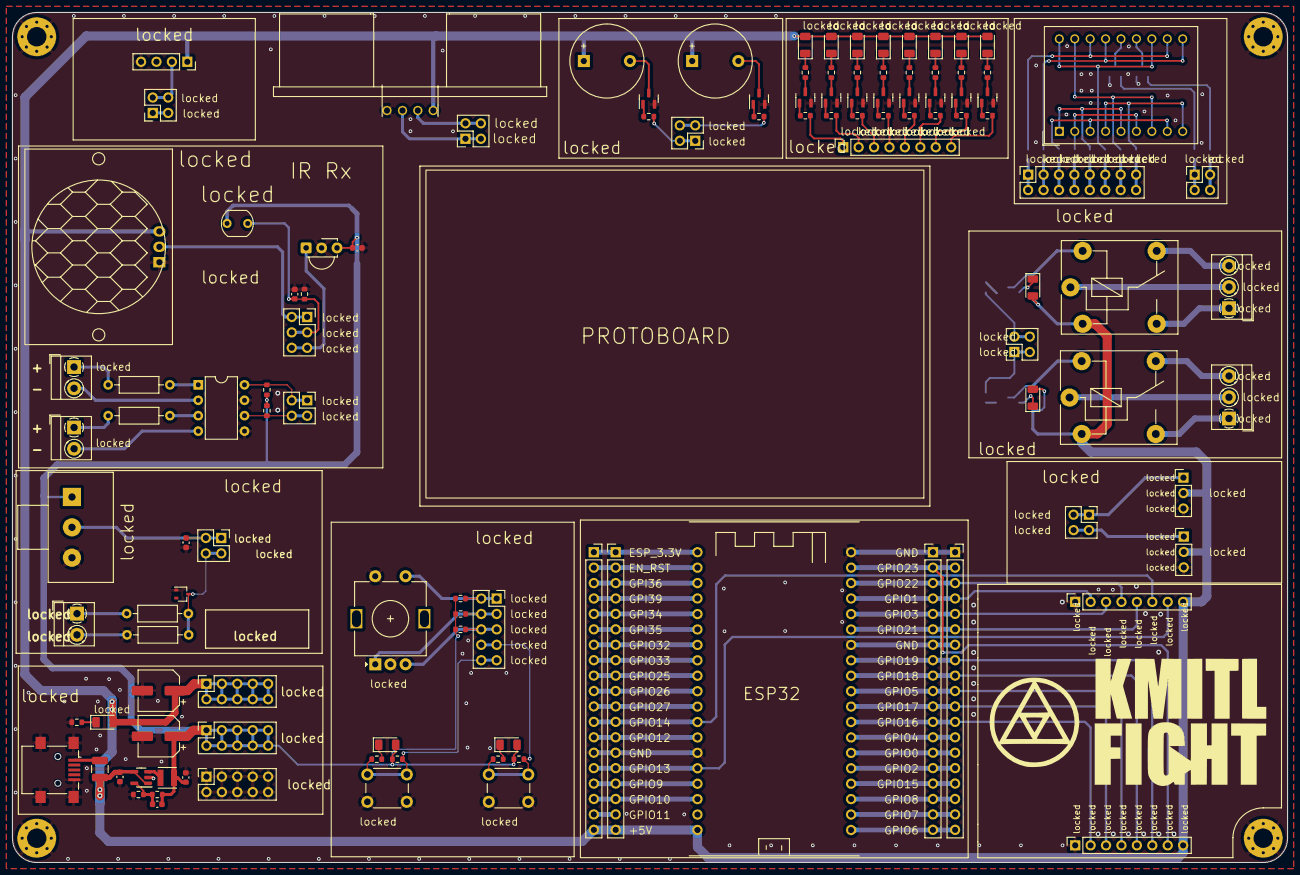
[picture p81: board Training_Based.kicad_pcb from above]

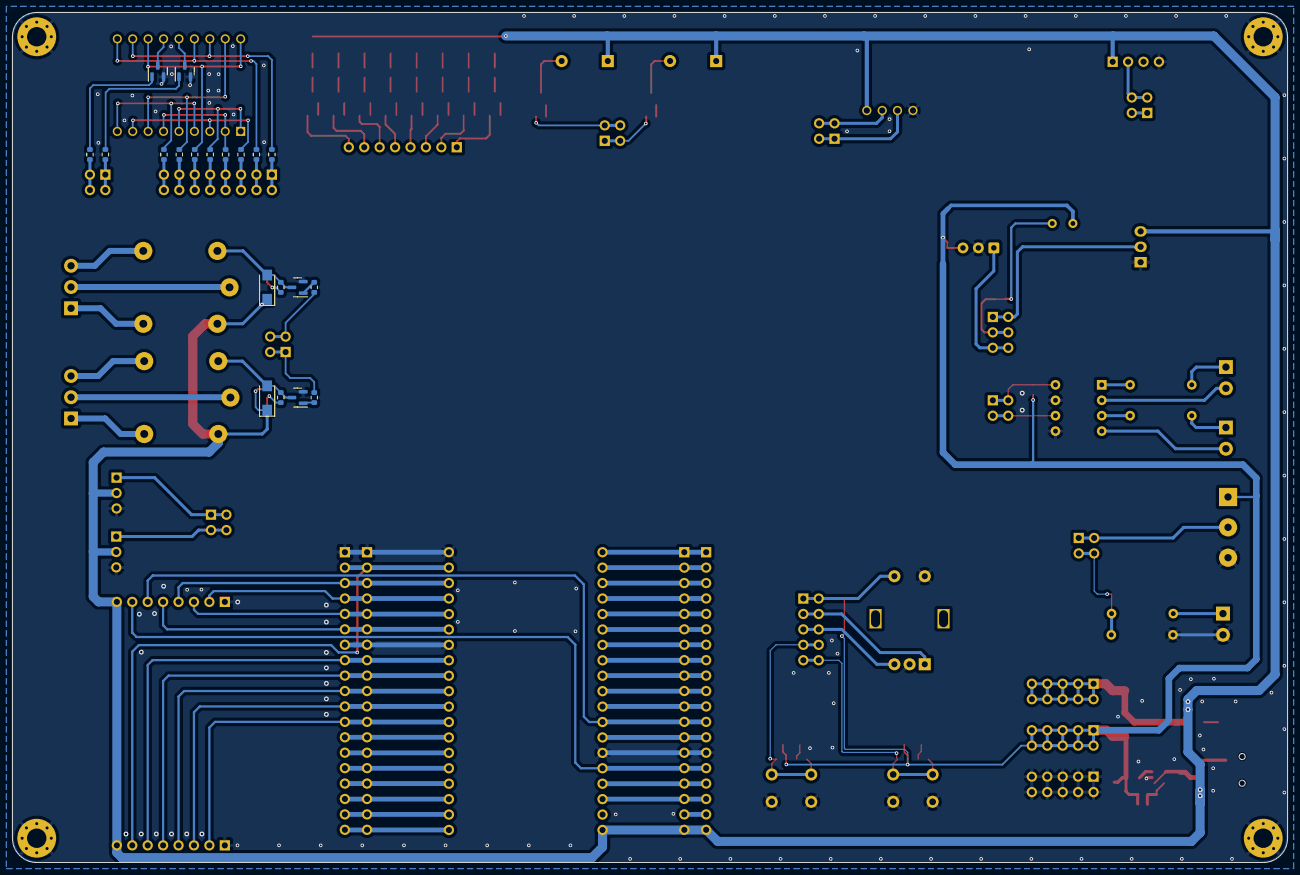
[picture p82: board Training_Based.kicad_pcb from below]

Board: 2 copper layers, 210.0 x 140.0 mm, 142 parts (20 on the bottom side), 142 nets.

Parts:
BZ1: Buzzer (IN); Buzzer_12x9.5RM7.6
BZ2: Buzzer (EX); Buzzer_12x9.5RM7.6
C1: 22uF/6.3V; C_0603_1608Metric
C2, C6, C8: 1nF; C_0603_1608Metric
C3, C5: 100uF/35V; CP_Elec_6.3x7.7
C4: 100nF; C_0603_1608Metric
C7: 0.1uF; C_0603_1608Metric
D1, D2: M7; DO-214AC
D3: BZX84C3V3LT1G; SOT-323_SC-70
F1: 3.00A; Fuse_1210_3225Metric
GKMITLLOGO: LOGO; KMITL
GSIETLOGO: LOGO; SIET_15x15
H1, H2, H3, H4: MountingHole_Pad; MountingHole_3.2mm_M3_Pad_Via
J1: ESP32_LEFT_A; PinHeader_1x19_P2.54mm_Vertical
J2: ESP32_LEFT_B; PinSocket_1x19_P2.54mm_Vertical
J3: ESP32_RIGHT_A; PinSocket_1x19_P2.54mm_Vertical
J4: ESP32_RIGHT_B; PinHeader_1x19_P2.54mm_Vertical
J5: LED x8; PinSocket_1x08_P2.54mm_Vertical
J6: TEMP-HUMID; PinSocket_2x02_P2.54mm_Vertical
J7: Ultrasonic; PinSocket_2x02_P2.54mm_Vertical
J8: Buzzer; PinSocket_2x02_P2.54mm_Vertical
J9: RELAY; PinSocket_2x02_P2.54mm_Vertical
J10: 7 Segment Digit; PinSocket_2x08_P2.54mm_Vertical
J11: 7 Segment Common; PinSocket_2x02_P2.54mm_Vertical
J12: SERVO MOTOR; PinSocket_2x02_P2.54mm_Vertical
J13: SERVO 1; PinHeader_1x03_P2.54mm_Vertical
J14: SERVO 2; PinHeader_1x03_P2.54mm_Vertical
J15: OPTO ISOLATOR; PinSocket_2x02_P2.54mm_Vertical
J16: OPTO; PinSocket_2x03_P2.54mm_Vertical
J17: SWITCH; PinSocket_2x05_P2.54mm_Vertical
J18: Analog Input; PinSocket_2x02_P2.54mm_Vertical
J19: USB_B_Mini; USB_Mini-B_Lumberg_2486_01_Horizontal
J20: +5V; PinSocket_2x05_P2.54mm_Vertical
J21: +3.3V; PinSocket_2x05_P2.54mm_Vertical
J22: GND; PinSocket_2x05_P2.54mm_Vertical
J23, J24: Conn_01x08; PinSocket_1x08_P2.54mm_Vertical
K1, K2: FINDER-36.11; Relay_SPDT_Finder_36.11
L1: 2.2uH/1.5A; L_Neosid_SMS-ME3015
LED1, LED2, LED3, LED4, LED5, LED6, LED7, LED8, LED9, LED10, LED11, LED12, LED13: RED 1206; LED_1206_3216Metric
P1: K1; TerminalBlock_MetzConnect_Type059_RT06303HBWC_1x03_P3.50mm_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
P2: K2; TerminalBlock_MetzConnect_Type059_RT06303HBWC_1x03_P3.50mm_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
P3: OPTO INPUT 1; TerminalBlock_MetzConnect_Type059_RT06302HBWC_1x02_P3.50mm_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
P4: OPTO INPUT 2; TerminalBlock_MetzConnect_Type059_RT06302HBWC_1x02_P3.50mm_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
P5: Voltage Input; TerminalBlock_MetzConnect_Type059_RT06302HBWC_1x02_P3.50mm_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
PIR1: PIR_Motion_Sensor; PIR_HC-SR501
Q1, Q2, Q3, Q4, Q5, Q6, Q7, Q8, Q9, Q10, Q11, Q12, Q13, Q14: BC817; SOT-23
R1, R4, R6, R8, R10, R12, R14, R16, R23, R24, R25, R26, R27, R28, R29, R30, R31, R32, R39, R42, R45: 470; R_0603_1608Metric
R2, R3, R5, R7, R9, R11, R13, R15, R17, R18, R38, R40, R41, R48, R49, R50: 10k; R_0603_1608Metric
R19, R20, R21, R22: 4.7k; R_0603_1608Metric
R33, R34: 1k; R_Axial_DIN0207_L6.3mm_D2.5mm_P10.16mm_Horizontal
R35, R36: 47k; R_0603_1608Metric
R37: LDR07; R_LDR_5.1x4.3mm_P3.4mm_Vertical
R43: 100k; R_Axial_DIN0207_L6.3mm_D2.5mm_P10.16mm_Horizontal
R44: 10k; R_Axial_DIN0207_L6.3mm_D2.5mm_P10.16mm_Horizontal
R46: 220k; R_0603_1608Metric
R47: 49.9k; R_0603_1608Metric
RV1: 50kB; Potentiometer_Alps_RK163_Single_Horizontal
SW1: RotaryEncoder_Switch; RotaryEncoder_Alps_EC11E-Switch_Vertical_H20mm
SW2, SW3: SW_Push; SW_PUSH_6mm_H5mm
TH2: DHT22_Temperature_Humidity; PinSocket_1x04_P2.54mm_Vertical
U1: HC-SR04
U2: Protoboard
U3: esp32_38_pins-custom_library; ESP32-DevKitC
U4: DC56-11SURKWA; DA56-11SURKWA
U5: LTV-827; DIP-8_W7.62mm
U6: TSOP382xx; Vishay_MINICAST-3Pin
U7: SY8089AAAC; SOT-23-5

Connections:
+3.3V: C2.1, C3.1, C4.1, C7.1, J21.1, J21.2, J21.3, J21.4, J21.5, J21.6, J21.7, J21.8, J21.9, J21.10, L1.2, LED11.2 (A), LED12.2 (A), R35.2, R36.2, R37.1, R40.1, R41.1, R46.1, R48.1, R49.1, R50.1, RV1.1, U6.3 (Vs)
+5V: BZ1.1 (-), BZ2.1 (-), C1.1, C5.1, D1.1 (K), D2.1 (K), F1.1, J1.19, J2.19, J13.2, J14.2, J20.1, J20.2, J20.3, J20.4, J20.5, J20.6, J20.7, J20.8, J20.9, J20.10, J23.8, J24.8, K1.A1, K2.A1, LED1.2 (A), LED2.2 (A), LED3.2 (A), LED4.2 (A), LED5.2 (A), LED6.2 (A), LED7.2 (A), LED8.2 (A), LED9.2 (A), LED10.2 (A), LED13.2 (A), PIR1.3 (VCC), TH2.1 (VDD), U1.1 (Vcc), U3.19 (5V), U7.1 (EN), U7.4 (IN)
/+3.3V_ESP: J1.1, J2.1, U3.1 (3.3V)
/A_Rotary: J17.3, J17.4, R48.2, SW1.A
/Analog_Input: D3.3 (K), J18.3, J18.4, R43.1, R44.2
/BUZZER1: J8.1, J8.3, R18.1
/BUZZER2: J8.2, J8.4, R17.1
/B_Rotary: J17.5, J17.6, R49.2, SW1.B
/DATA: J6.3, J6.4, TH2.2 (DATA)
/DIG1: J11.1, J11.2, R21.1
/DIG2: J11.3, J11.4, R22.1
/EN_RST: J1.2, J2.2, U3.2 (EN_RST)
/Echo: J7.1, J7.2, U1.3 (Echo)
/GPI34: J1.5, J2.5, U3.5 (GPI34)
/GPI35: J1.6, J2.6, U3.6 (GPI35)
/GPI36: J1.3, J2.3, U3.3 (GPI36)
/GPI39: J1.4, J2.4, U3.4 (GPI39)
/GPIO0: J3.14, J4.14, U3.25 (GPIO0)
/GPIO1: J3.4, J4.4, J23.2, U3.35 (GPIO1)
/GPIO2: J3.15, J4.15, U3.24 (GPIO2)
/GPIO3: J3.5, J4.5, J23.3, U3.34 (GPIO3)
/GPIO4: J3.13, J4.13, U3.26 (GPIO4)
/GPIO5: J3.10, J4.10, J24.4, U3.29 (GPIO5)
/GPIO6: J3.19, J4.19, U3.20 (GPIO6)
/GPIO7: J3.18, J4.18, U3.21 (GPIO7)
/GPIO8: J3.17, J4.17, U3.22 (GPIO8)
/GPIO9: J1.16, J2.16, U3.16 (GPIO9)
/GPIO10: J1.17, J2.17, U3.17 (GPIO10)
/GPIO11: J1.18, J2.18
/GPIO12: J1.13, J2.13, U3.13 (GPIO12)
/GPIO13: J1.15, J2.15, J23.7, U3.15 (GPIO13)
/GPIO14: J1.12, J2.12, J23.6, U3.12 (GPIO14)
/GPIO15: J3.16, J4.16, U3.23 (GPIO15)
/GPIO16: J3.12, J4.12, J24.2, U3.27 (GPIO16)
/GPIO17: J3.11, J4.11, J24.3, U3.28 (GPIO17)
/GPIO18: J3.9, J4.9, J24.5, U3.30 (GPIO18)
/GPIO19: J3.8, J4.8, J24.6, U3.31 (GPIO19)
/GPIO21: J3.6, J4.6, J23.5, U3.33 (GPIO21)
/GPIO22: J3.3, J4.3, J23.4, U3.36 (GPIO22)
/GPIO23: J3.2, J4.2, J24.7, U3.37 (GPIO23)
/GPIO25: J1.9, J2.9, U3.9 (GPIO25)
/GPIO26: J1.10, J2.10, U3.10 (GPIO26)
/GPIO27: J1.11, J2.11, U3.11 (GPIO27)
/GPIO32: J1.7, J2.7, U3.7 (GPIO32)
/GPIO33: J1.8, J2.8, U3.8 (GPIO33)
/IRRX_OUTPUT: J16.5, J16.6, U6.1 (OUT)
/LDR_OUTPUT: C6.1, J16.3, J16.4, R37.2, R38.2
/LED1: J5.1, R2.1
/LED2: J5.2, R3.1
/LED3: J5.3, R5.1
/LED4: J5.4, R7.1
/LED5: J5.5, R9.1
/LED6: J5.6, R11.1
/LED7: J5.7, R13.1
/LED8: J5.8, R15.1
/LX: L1.1, U7.3 (LX)
/PIR_DATA: J16.1, J16.2, PIR1.2 (DATA)
/POTO_OUT1: J15.1, J15.2, R35.1, U5.8
/POTO_OUT2: J15.3, J15.4, R36.1, U5.6
/Poten_voltage: C8.1, J18.1, J18.2, RV1.2
/RELAY1: J9.1, J9.2, R19.1
/RELAY2: J9.3, J9.4, R20.1
/S1_PB: J17.7, J17.8, R39.2, R40.2, SW2.2
/S1_Rotary: J17.1, J17.2, R50.2, SW1.S1
/S2_PB: J17.9, J17.10, R41.2, R42.2, SW3.2
/SEG_A: J10.1, J10.2, R23.1
/SEG_B: J10.3, J10.4, R24.1
/SEG_C: J10.5, J10.6, R25.1
/SEG_D: J10.7, J10.8, R26.1
/SEG_DP: J10.15, J10.16, R30.1
/SEG_E: J10.9, J10.10, R27.1
/SEG_F: J10.11, J10.12, R28.1
/SEG_G: J10.13, J10.14, R29.1
/SERVO1: J12.1, J12.2, J13.1
/SERVO2: J12.3, J12.4, J14.1
/S_A: R23.2, U4.11 (DIG2_A), U4.16 (DIG1_A)
/S_B: R24.2, U4.10 (DIG2_B), U4.15 (DIG1_B)
/S_C: R25.2, U4.3 (DIG1_C), U4.8 (DIG2_C)
/S_D: R26.2, U4.2 (DIG1_D), U4.6 (DIG2_D)
/S_DP: R30.2, U4.4 (DP1), U4.9 (DP2)
/S_E: R27.2, U4.1 (DIG1_E), U4.5 (DIG2_E)
/S_F: R28.2, U4.12 (DIG2_F), U4.18 (DIG1_F)
/S_G: R29.2, U4.7 (DIG2_G), U4.17 (DIG1_G)
/Trig: J7.3, J7.4, U1.2 (Trig)
GND: C1.2, C3.2, C4.2, C5.2, C6.2, C7.2, C8.2, D3.1 (A), H1.1, H2.1, H3.1, H4.1, J1.14, J2.14, J3.1, J3.7, J4.1, J4.7, J13.3, J14.3, J19.5 (GND), J19.6 (Shield), J22.1, J22.2, J22.3, J22.4, J22.5, J22.6, J22.7, J22.8, J22.9, J22.10, J23.1, J24.1, P5.2, PIR1.1 (GND), Q1.2 (E), Q2.2 (E), Q3.2 (E), Q4.2 (E), Q5.2 (E), Q6.2 (E), Q7.2 (E), Q8.2 (E), Q9.2 (E), Q10.2 (E), Q11.2 (E), Q12.2 (E), Q13.2 (E), Q14.2 (E), R38.1, R44.1, R45.2, R47.2, RV1.3, SW1.C, SW1.S2, SW2.1, SW3.1, TH2.4 (GND), U1.4 (Gnd), U3.14 (GND), U3.32 (GND), U3.38 (GND), U5.5, U5.7, U6.2 (GND), U7.2 (GND)
unnamed: BZ1.2 (+), Q1.3 (C)
unnamed: BZ2.2 (+), Q10.3 (C)
unnamed: D1.2 (A), K1.A2, Q11.3 (C), R31.2
unnamed: D2.2 (A), K2.A2, Q12.3 (C), R32.2
unnamed: J6.1, J6.2
unnamed: F1.2, J19.1 (VBUS)
unnamed: LED1.1 (K), R1.1
unnamed: LED2.1 (K), R4.1
unnamed: LED3.1 (K), R6.1
unnamed: LED4.1 (K), R8.1
unnamed: LED5.1 (K), R10.1
unnamed: LED6.1 (K), R12.1
unnamed: LED7.1 (K), R14.1
unnamed: LED8.1 (K), R16.1
unnamed: LED9.1 (K), R31.1
unnamed: LED10.1 (K), R32.1
unnamed: LED11.1 (K), R39.1
unnamed: LED12.1 (K), R42.1
unnamed: LED13.1 (K), R45.1
unnamed: K1.14, P1.1
unnamed: K1.11, P1.2
unnamed: K1.12, P1.3
unnamed: K2.14, P2.1
unnamed: K2.11, P2.2
unnamed: K2.12, P2.3
unnamed: P3.1, R33.1
unnamed: P3.2, U5.2
unnamed: P4.1, R34.1
unnamed: P4.2, U5.4
unnamed: P5.1, R43.2
unnamed: Q1.1 (B), R18.2
unnamed: Q2.1 (B), R2.2
unnamed: Q2.3 (C), R1.2
unnamed: Q3.1 (B), R3.2
unnamed: Q3.3 (C), R4.2
unnamed: Q4.1 (B), R5.2
unnamed: Q4.3 (C), R6.2
unnamed: Q5.1 (B), R7.2
unnamed: Q5.3 (C), R8.2
unnamed: Q6.1 (B), R9.2
unnamed: Q6.3 (C), R10.2
unnamed: Q7.1 (B), R11.2
unnamed: Q7.3 (C), R12.2
unnamed: Q8.1 (B), R13.2
unnamed: Q8.3 (C), R14.2
unnamed: Q9.1 (B), R15.2
unnamed: Q9.3 (C), R16.2
unnamed: Q10.1 (B), R17.2
unnamed: Q11.1 (B), R19.2
unnamed: Q12.1 (B), R20.2
unnamed: Q13.1 (B), R21.2
unnamed: Q13.3 (C), U4.14 (DIG1_CC)
unnamed: Q14.1 (B), R22.2
unnamed: Q14.3 (C), U4.13 (DIG2_CC)
unnamed: R33.2, U5.1
unnamed: R34.2, U5.3
unnamed: C2.2, R46.2, R47.1, U7.5 (FB)
