Special-Topic-2565-01/Training_Base/(commit log)

2022-07-21 add spacerx6
    [Plastic Stick Fixed Clip On PCB.stp, Training_Based.kicad_pcb, Training_Based.kicad_sch]
2022-07-22 ีWork in Progress
    [PIR_lens.STEP, PIR_sensor board.STEP, PIR_sensor.STEP, Training_Based.kicad_pcb, Training_Based.kicad_sch]
2022-07-22 add esp32 board and 3d model
    [Training_Based.kicad_pcb, Training_Based.kicad_sch]
2022-07-22 work in progress 650723.0501
    [Training_Based.kicad_pcb, Training_Based.kicad_sch]
2022-07-22 WIP 6507230502
    [Training_Based.kicad_pcb, Training_Based.kicad_sch]
2022-07-23 add 3D Model
    [DHT11.stp]
2022-07-23 7 segment and relay
    [DO-214AC.step, Training_Based.kicad_pcb, Training_Based.kicad_sch]
2022-07-23 opto isolator
    [Training_Based.kicad_pcb, Training_Based.kicad_sch]
2022-07-24 update Optoelectronic parts
    [Training_Based.kicad_pcb, Training_Based.kicad_sch]
2022-07-24 add library
    [EC11B-SW-Vert-15F-green.step]
2022-07-24 add tact switch and rotary switch
    [Training_Based.kicad_pcb, Training_Based.kicad_sch]
2022-07-24 finish layout
    [Training_Based.kicad_pcb, Training_Based.kicad_sch]
2022-08-06 WIP 650806-1532
    [Training_Based.kicad_pcb, Training_Based.kicad_sch]
2022-08-07 Final Check
    [Training_Based.kicad_pcb, Training_Based.kicad_sch]
2022-08-07 Final 650807
    [Training_Based.kicad_pcb, Training_Based.kicad_sch]
2022-08-09 generate gerber
    [Training_Based-B_Cu.gbl, Training_Based-B_Mask.gbs, Training_Based-B_Paste.gbp, Training_Based-B_Silkscreen.gbo, Training_Based-Edge_Cuts.gm1, Training_Based-F_Cu.gtl, Training_Based-F_Mask.gts, Training_Based-F_Paste.gtp]
